ivanroigperez/prueba/trabajo/Guia_EcoIt.docx

DOCUMENTO INTERNO · NO SE ENTREGA

Guía para hacer el ACV con Eco-it

Trabajo de Ingeniería Simultánea: taburete-escalera plegable · Iván Roig Pérez

# 1. Qué hay que hacer

El profesor pide «un pequeño ACV del producto usando el software Eco-it». Yo no puedo ejecutar Eco-it, así que el capítulo 4 del trabajo ya tiene escrito todo lo demás (método, datos de entrada, comentarios y conclusiones) y deja en amarillo los huecos para los resultados. En la práctica del martes solo tienes que:

1. Crear en Eco-it las tres alternativas con los datos de las tablas de esta guía (si vas justo, como mínimo la alternativa 2).
2. En la alternativa 2, guardar una copia cambiando el aluminio primario por aluminio reciclado (es la variante de las conclusiones).
3. Hacer una captura de la pantalla de resultados de cada alternativa y anotar el valor de cada fase: producción, uso y eliminación.
4. Pegar las capturas y los valores en los huecos amarillos del capítulo 4 (o pasármelos y lo completo yo, junto con el gráfico comparativo).

Si el profesor dice que basta con el producto final, haz solo la alternativa 2 con su variante de aluminio reciclado y avísame: quito los apartados 4.2 y 4.4 y adapto la comparativa.

# 2. Antes de empezar

- Método de cálculo: si Eco-it deja elegir, usa la huella de carbono (kg CO₂-eq), que es lo que usa el índice de ejemplo del profesor. Si en clase usáis el Eco-indicador 99 (resultados en puntos o milipuntos), apunta los valores en esas unidades y dímelo para cambiar «kg CO₂-eq» en el texto.
- Nombres de los materiales: los de las tablas son genéricos. En Eco-it elige el material o proceso más parecido de su base de datos (por ejemplo, «aluminio primario» y «extrusión de aluminio»).
- Unidades: Eco-it trabaja en kg y en t·km. Todas las cantidades de esta guía ya están en esas unidades.
- El transporte de distribución (600 km en camión) se mete en la fase de producción, como dice el apartado 4.1. Si en clase lo ponéis en otra fase, cambia la frase del 4.1 y el nombre de la fila «Producción (incluye el transporte)».
- Si Eco-it permite dividir el producto en partes, crea una parte por cada fila de la tabla de producción: así podrás sacar el gráfico de impacto por componente, como en el índice de ejemplo.

# 3. Alternativa 2: aluminio y polipropileno (la elegida)

Fase / elemento | Material o proceso en Eco-it | Cantidad
PRODUCCIÓN
Largueros delanteros (2) | Aluminio primario + extrusión de aluminio | 0,963 kg
Patas traseras (2) | Aluminio primario + extrusión de aluminio | 0,893 kg
Travesaños (2) | Aluminio primario + extrusión de aluminio | 0,299 kg
Bielas y tirantes (4) | Aluminio primario + extrusión de aluminio | 0,136 kg
Plataforma | Polipropileno (PP) + moldeo por inyección | 0,363 kg
Peldaño | Polipropileno (PP) + moldeo por inyección | 0,297 kg
Pasadores (10) | Acero | 0,176 kg
Tacos (4) | Caucho | 0,042 kg
TRANSPORTE (dentro de producción)
Distribución, 600 km | Camión | 1,90 t·km
USO
Tacos de repuesto (4) | Caucho | 0,042 kg
ELIMINACIÓN
Metales reciclados (90 %) | Reciclaje de aluminio / reciclaje de acero | 2,063 kg / 0,158 kg
Metales a vertedero (10 %) | Vertedero | 0,247 kg
Plástico | Incineración de PP | 0,660 kg
Caucho (original y repuesto) | Incineración | 0,083 kg

Variante con aluminio reciclado: copia el producto y cambia «aluminio primario» por «aluminio reciclado» en las cuatro primeras filas (2,291 kg en total). Lo demás no cambia.

# 4. Alternativa 1: acero

Fase / elemento | Material o proceso en Eco-it | Cantidad
PRODUCCIÓN
Largueros delanteros (2) | Acero + conformado de tubo | 2,782 kg
Patas traseras (2) | Acero + conformado de tubo | 2,580 kg
Travesaños (2) | Acero + conformado de tubo | 0,865 kg
Plataforma y peldaño | Chapa de acero + estampación o doblado | 2,359 kg
Bielas y tirantes (4) | Acero | 0,394 kg
Pasadores (10) | Acero | 0,176 kg
Tacos (4) | Caucho | 0,042 kg
TRANSPORTE (dentro de producción)
Distribución, 600 km | Camión | 5,52 t·km
USO
Tacos de repuesto (4) | Caucho | 0,042 kg
ELIMINACIÓN
Acero reciclado (90 %) | Reciclaje de acero | 8,241 kg
Acero a vertedero (10 %) | Vertedero | 0,916 kg
Caucho (original y repuesto) | Incineración | 0,083 kg

# 5. Alternativa 3: madera

Fase / elemento | Material o proceso en Eco-it | Cantidad
PRODUCCIÓN
Largueros delanteros (2) | Madera dura (haya), aserrada | 0,712 kg
Patas traseras (2) | Madera dura (haya), aserrada | 0,661 kg
Travesaños (2) | Madera dura (haya), aserrada | 0,172 kg
Plataforma y peldaño | Contrachapado | 1,801 kg
Bielas y tirantes (4) | Acero | 0,394 kg
Pasadores (10) | Acero | 0,176 kg
Tacos (4) | Caucho | 0,042 kg
TRANSPORTE (dentro de producción)
Distribución, 600 km | Camión | 2,37 t·km
USO
Tacos de repuesto (4) | Caucho | 0,042 kg
ELIMINACIÓN
Madera | Incineración con recuperación de energía | 3,346 kg
Acero reciclado (90 %) | Reciclaje de acero | 0,513 kg
Acero a vertedero (10 %) | Vertedero | 0,057 kg
Caucho (original y repuesto) | Incineración | 0,083 kg

# 6. Dónde va cada resultado en el Word

Resultado de Eco-it | Dónde va en el capítulo 4
Valores por fase de la alternativa 1 | Tabla 13 y texto del apartado 4.2
Valores por fase de la alternativa 2 (primario y reciclado) | Tabla 14, texto del 4.3 y segunda conclusión del 4.5
Valores por fase de la alternativa 3 | Tabla 15 y texto del 4.4
Captura de resultados de cada alternativa | Ilustraciones 18, 21 y 22 (huecos amarillos)
Totales de las tres alternativas | Fila «Impacto del ciclo de vida» de la Tabla 16
Gráfico comparativo por fases | Ilustración 23 (si me pasas los valores, lo hago yo)

Al terminar, borra la nota amarilla del principio del capítulo 4 y comprueba que no queda ningún hueco amarillo (Ctrl+B y busca «[»).

# 7. Comprobación rápida de errores

Antes de Eco-it hice una estimación con otra base de datos (factores ICE de la Universidad de Bath). No sirve como resultado, porque el profesor pide Eco-it, pero sí para detectar errores al meter los datos:

Alternativa | Estimación previa (kg CO₂-eq)
1. Acero | ≈ 14
2. Aluminio + PP (aluminio primario) | ≈ 27
2. Con aluminio reciclado | ≈ 11
3. Madera | ≈ 3

- Diferencias de hasta un 50 % son normales: las bases de datos no son iguales.
- Si un resultado sale unas 1.000 veces mayor o menor, casi seguro que has metido gramos en lugar de kilos (o kg en lugar de t·km en el transporte).
- Lo que sí debería salir igual: la producción es la fase con más impacto en las tres alternativas y el uso es casi nulo. Si Eco-it dice otra cosa, revisa los datos o avísame, porque habría que cambiar los comentarios del capítulo.
