ivanroigperez/prueba/trabajo/Dudas_y_decisiones.docx

DOCUMENTO INTERNO · NO SE ENTREGA

Dudas y decisiones tomadas por intuición

Trabajo de Ingeniería Simultánea: taburete-escalera plegable · Iván Roig Pérez

Durante el trabajo he tenido que tomar muchas decisiones sin un enunciado ni un criterio del profesor que las respaldara. Aquí están todas las que no puedo justificar del todo: qué decidí, por qué, qué duda me queda y cómo comprobarla. Están ordenadas por lo que podrían afectar a la nota. Úsalo para preparar la defensa y, si puedes, para preguntar al profesor antes de entregar.

Impacto: Alto = podría cambiar una conclusión o costar bastante nota. Medio = discutible, pero defendible si lo explicas. Bajo = detalle.

Resumen

Nº | Duda | Impacto
1 | El ACV con Eco-it solo se ha hecho para la alternativa 2 (4) | Medio
2 | Decisión final: aluminio reciclado (antes era la madera) (4.1 y 4.4) | Medio
3 | Comprobaciones por cálculo manual (3.5) | Medio
4 | El pestillo está dimensionado pero no modelado (3.5 y 5.2) | Medio
5 | El capítulo 5 (QFD, AMFEC y análisis del valor) no lo pide el profesor (5) | Medio
6 | Hipótesis del ACV (4.2) | Medio
7 | Estudio de patentes no exhaustivo (2.5) | Medio
8 | Altura de 0,48 m a partir de un alcance de 1,24 veces la estatura (1.3) | Medio
9 | Costes y márgenes inventados (2.1) | Medio
10 | Qué entiende el profesor por «estructura» (1.7) | Bajo
11 | El AMFEC no calcula la criticidad (G × O) (5.2) | Bajo
12 | No he tenido acceso al texto de la UNE-EN 14183 (2.4 y normativa) | Bajo
13 | Elección de parámetros TRIZ (3.2) | Bajo
14 | QFD y AMFEC sin datos de clientes ni de ensayos (5) | Bajo
15 | Materiales de SolidWorks aproximados (3.4) | Bajo
16 | Datos de mercado (2.2) | Bajo
17 | Tres planos, generados por programa y no desde SolidWorks (6) | Bajo
18 | Embalaje y paletización (2.10) | Bajo

## 1. El ACV con Eco-it solo se ha hecho para la alternativa 2

IMPACTO MEDIO Apartado: 4

Qué decidí: Hacer el ACV en Eco-it solo de la alternativa elegida (aluminio y PP) y de su variante con aluminio reciclado. El capítulo 4 queda así: 4.1 selección frente al EDP (Tabla 12), 4.2 método y datos (Tabla 13), 4.3 resultados y 4.4 conclusiones.

Por qué: El profesor pide «un pequeño ACV del producto usando el software Eco-it», en singular, y lo repite en el mismo mensaje. El acero y la madera ya quedan descartados por el peso (P5) antes del ACV.

Qué duda me queda: Si el profesor esperaba comparar las tres alternativas, falta el ACV del acero y de la madera. Con los factores de Eco-it, el acero rondaría los 20 kg CO₂-eq (estimación mía, no calculada en Eco-it): con aluminio primario (35) la alternativa elegida sería la de más impacto, y con aluminio reciclado (10,5) pasa a ser mejor que el acero.

Cómo comprobarlo: Pregúntale al profesor si basta con el producto. Si pide las tres, se hacen en Eco-it partiendo del archivo de la alternativa 2 (unos 10-15 minutos cada una) y vuelvo a meter los apartados. Si en la defensa te preguntan por qué no el acero, la respuesta es el peso (P5) y el dato del aluminio reciclado.

## 2. Decisión final: aluminio reciclado (antes era la madera)

IMPACTO MEDIO Apartado: 4.1 y 4.4

Qué decidí: Aplicar primero un filtro de requisitos imprescindibles (Tabla 12). El acero y la madera no cumplen P5 y quedan descartados, así que se elige el aluminio reciclado.

Por qué: Otra revisión detectó que la versión anterior elegía la madera, que pesa 3,96 kg, y que la matriz le daba un 4 en peso. Con un 1 en peso ganaba el aluminio. Ahora la conclusión coincide con el modelo, los planos y el capítulo 5.

Qué duda me queda: La madera queda descartada por un peso calculado con una sección simplificada. Puede que un diseño de madera bien hecho también cumpla, pero no está demostrado.

Cómo comprobarlo: Si te preguntan por qué no la madera: incumple un requisito imprescindible y su modelo no está verificado. Queda como línea futura.

## 3. Comprobaciones por cálculo manual

IMPACTO MEDIO Apartado: 3.5

Qué decidí: Añadir el apartado 3.5 con cálculos sencillos: flexión y pandeo del larguero, plataforma, pasadores, vuelco y mecanismo.

Por qué: No había ninguna comprobación de P1, P2 ni R3.

Qué duda me queda: Los cálculos son simplificados (viga biapoyada, carga estática de 150 kg, coeficiente de seguridad de 2) y no sustituyen a un estudio por elementos finitos ni a los ensayos de la norma. La plataforma y el peldaño cumplen por poco (coeficiente de seguridad 2,0) y el peso final estimado (3,46 kg) apenas cumple P5. Los nervios no están dibujados en el modelo ni en los planos.

Cómo comprobarlo: Si quieres reforzarlo, haz un estudio estático de la plataforma en SolidWorks Simulation.

## 4. El pestillo está dimensionado pero no modelado

IMPACTO MEDIO Apartado: 3.5 y 5.2

Qué decidí: Calcular con el modelo cinemático cómo actúa el peso del usuario y dimensionar el pestillo en la articulación del peldaño.

Por qué: El cálculo demuestra que el peso sobre el peldaño tiende a cerrar el taburete, así que el pestillo es imprescindible.

Qué duda me queda: El pestillo sigue sin estar en el modelo 3D ni en los planos.

Cómo comprobarlo: Explícalo como diseño de detalle pendiente. Los números (522 N·m y unos 710 N por pasador) están en la Tabla 11.

## 5. El capítulo 5 (QFD, AMFEC y análisis del valor) no lo pide el profesor

IMPACTO MEDIO Apartado: 5

Qué decidí: Mantener las técnicas de rediseño como capítulo 5, entre la evaluación y la realización.

Por qué: Son materia del curso (apuntes de Técnicas de rediseño) y el capítulo está completo.

Qué duda me queda: El mensaje del profesor enumera las fases inicial, de información, técnico-creativa, de evaluación y de realización; el rediseño no aparece. Puede valorarlo, ignorarlo o preferir un trabajo más corto.

Cómo comprobarlo: Si quieres quitarlo, se elimina el capítulo 5 entero y hay que cambiar dos frases que lo citan (en el 2.1 y el 3.4). Dímelo y lo hago.

## 6. Hipótesis del ACV

IMPACTO MEDIO Apartado: 4.2

Qué decidí: 600 km de transporte en camión, reciclaje del 90 % de los metales, cambio de tacos una vez en 10 años, incineración del polipropileno y del caucho.

Por qué: Son valores razonables y habituales en ACV simplificados, y se pueden meter tal cual en Eco-it.

Qué duda me queda: Ninguno está medido. Además, el ACV no incluye el embalaje, el anodizado ni las mermas de fabricación (ya está dicho en el 4.2).

Cómo comprobarlo: Si en la práctica el profesor da otros escenarios (por ejemplo, otro porcentaje de reciclaje o un escenario de residuos urbanos de Eco-it), usa los suyos y cambia la frase del 4.2.

## 7. Estudio de patentes no exhaustivo

IMPACTO MEDIO Apartado: 2.5

Qué decidí: Analizar 4 documentos cercanos y citar 3 más.

Por qué: El índice pide 4 patentes.

Qué duda me queda: ES 1 070 877 U no puede estar en vigor: un modelo de utilidad dura como máximo 10 años y se solicitó en 2009. De US 12 419 421 B2 he confirmado titular, inventores, clasificación y fecha de concesión (23/09/2025), pero no la familia en otros países, porque Google Patents, Espacenet y la USPTO bloquean el acceso desde aquí. Tampoco he podido volver a comprobar que US 6 966 404 caducara por impago (en 2026 está expirada en cualquier caso).

Cómo comprobarlo: Busca US12419421B2 en worldwide.espacenet.com y mira «Also published as» o la pestaña de familia. Si sale una solicitud EP o WO, avísame: cambia la frase de que no afecta en España. Son 2 minutos.

## 8. Altura de 0,48 m a partir de un alcance de 1,24 veces la estatura

IMPACTO MEDIO Apartado: 1.3

Qué decidí: Usar la usuaria de percentil 5 (1,49 m) y un alcance de 1,24 × estatura para llegar a 2,30 m.

Por qué: Da un valor que coincide con los productos de referencia (Hailo K20: 46 cm).

Qué duda me queda: El factor 1,24 es una aproximación mía, no un dato de la tabla del INSHT. Los datos del INSHT son de 1999 y de población laboral (18 a 65 años), justo cuando digo que el producto está pensado también para personas mayores, que son más bajas. El objetivo de 2,30 m también lo fijé yo.

Cómo comprobarlo: Si en clase habéis usado otra tabla de alcance vertical, cambia el factor. Si el resultado sigue entre 0,45 y 0,50 m, el diseño no cambia.

## 9. Costes y márgenes inventados

IMPACTO MEDIO Apartado: 2.1

Qué decidí: Margen de la distribución del 38 %, margen del fabricante del 25 %, serie de 20.000 unidades al año y un reparto del coste industrial.

Por qué: Son hipótesis habituales y quedan marcadas como tales.

Qué duda me queda: No hay datos reales detrás. Los costes por componente del análisis del valor también son estimados, y su suma (13,46 €) supera lo previsto (12,50 €); lo he dejado escrito como hallazgo, no lo he escondido.

Cómo comprobarlo: Defiéndelo como estimación de orden de magnitud. Si en clase dieron márgenes típicos, usa esos.

## 10. Qué entiende el profesor por «estructura»

IMPACTO BAJO Apartado: 1.7

Qué decidí: Añadir el apartado 1.7 con el árbol de estructura del producto: conjunto, subconjuntos, piezas y la función de cada parte.

Por qué: El mensaje del profesor incluye «estructura» en la fase inicial, y el índice de ejemplo habla de «estructura de descomposición del producto», que es justo un árbol de conjuntos, subconjuntos y piezas.

Qué duda me queda: Los apuntes de la asignatura no están en abierto y no he podido comprobar la definición exacta (3/11/2026). Confianza: alrededor del 80 %.

Cómo comprobarlo: Si en los apuntes de Metodologías la «estructura» es la funcional y no la de piezas, avísame y lo adapto (el árbol de funciones del 1.4 ya cubre parte).

## 11. El AMFEC no calcula la criticidad (G × O)

IMPACTO BAJO Apartado: 5.2

Qué decidí: Usar solo el IPR = O × G × D.

Por qué: Es lo único que definen los apuntes de Técnicas de rediseño; la palabra «criticidades» solo aparece en el nombre de la técnica.

Qué duda me queda: Otra revisión lo señaló como fallo. Según tus apuntes no lo es, pero algunos profesores lo piden.

Cómo comprobarlo: Si quieres cubrirte, añade una columna G × O a la Tabla 15. Son 8 multiplicaciones.

## 12. No he tenido acceso al texto de la UNE-EN 14183

IMPACTO BAJO Apartado: 2.4 y normativa

Qué decidí: Describir la norma a partir de fuentes secundarias (AFESPO, Test and Research Centre, fichas de fabricantes).

Por qué: La norma es de pago.

Qué duda me queda: Comprobado el 3/11/2026: todo lo que dice el trabajo (150 kg, plataforma de hasta 1 m, peldaños a la misma distancia que del suelo al primero, barandilla si la plataforma es menor de 24 × 40 cm y está a más de 75 cm, solo ensayos de resistencia y deslizamiento lateral, sin marcado CE) coincide con las dos fuentes citadas. El texto oficial sigue sin consultar.

Cómo comprobarlo: Si la biblioteca de la universidad tiene acceso a AENOR, consulta la norma y corrige lo que haga falta.

## 13. Elección de parámetros TRIZ

IMPACTO BAJO Apartado: 3.2

Qué decidí: Contradicciones 14/1, 33/27 y 13/7.

Por qué: Son las que mejor describen el problema.

Qué duda me queda: Comprobadas el 3/11/2026 con la matriz clásica de Altshuller (hoja de cálculo de J. Hipple): 14/1 (1, 8, 40, 15) y 33/27 (17, 27, 8, 40) coinciden. La 13/7 decía 28, 10, 1 y 39 y es 28, 10, 19 y 39; ya está corregida. El parámetro 13 de TRIZ es la estabilidad de la composición del objeto, y aquí se usa como estabilidad frente al vuelco; un profesor estricto lo podría señalar.

Cómo comprobarlo: Si vuestra matriz de clase es otra versión, compara solo esas tres celdas.

## 14. QFD y AMFEC sin datos de clientes ni de ensayos

IMPACTO BAJO Apartado: 5

Qué decidí: Importancias, relaciones, percepción de la competencia y valores O, G y D puestos por mí.

Por qué: Es un trabajo académico sin encuestas ni prototipo.

Qué duda me queda: Los resultados (por ejemplo, que el peso sea lo más importante con un 15,7 %) salen de mis propias puntuaciones, así que en parte confirman lo que yo ya pensaba.

Cómo comprobarlo: Admítelo si te preguntan: en un proyecto real se harían encuestas a usuarios y ensayos de prototipos.

## 15. Materiales de SolidWorks aproximados

IMPACTO BAJO Apartado: 3.4

Qué decidí: PP copolímero en lugar de PP con 30 % de fibra de vidrio, haya en lugar de contrachapado en la plataforma y acero al carbono no aleado en lugar de S235.

Por qué: Son los que había en la biblioteca de SolidWorks en español.

Qué duda me queda: Las masas cambian poco (unos 170 g en el PP, ya indicado en el texto), pero el ACV usa el factor del contrachapado con la masa calculada con la densidad de la haya.

Cómo comprobarlo: Si quieres afinar, crea materiales personalizados en SolidWorks con la densidad correcta.

## 16. Datos de mercado

IMPACTO BAJO Apartado: 2.2

Qué decidí: Precios y características tomados de webs de tiendas en septiembre de 2026.

Por qué: No hay otra fuente.

Qué duda me queda: Comprobado en ikea.es el 3/11/2026: el BOLMEN cuesta 4,99 € (el trabajo decía 1,50 €; ya está corregido en la Tabla 4 y en la Ilustración 6) y el BEKVÄM sigue a 24,99 €. Varios pesos figuran como «n. d.».

Cómo comprobarlo: Nada pendiente.

## 17. Tres planos, generados por programa y no desde SolidWorks

IMPACTO BAJO Apartado: 6

Qué decidí: Dejar tres planos: conjunto abierto con lista de piezas, conjunto plegado y plano de fabricación del larguero delantero (con material, tolerancias, acabado y proceso).

Por qué: El profesor pide dos planos, uno de conjunto y otro de detalle o fabricación de una pieza. He quitado los de plataforma y peldaño y de piezas varias: no hacían falta y el de la plataforma no mostraba los nervios del apartado 3.5.

Qué duda me queda: Están dibujados proyectando el modelo con un programa, no con SolidWorks. Si el profesor pide los archivos de dibujo de SolidWorks, no los tienes.

Cómo comprobarlo: Si te los piden, usa la macro de planos (cad/Planos_macro_para_copiar.txt): crea más hojas de las necesarias; quédate con la de conjunto y añade las cotas a mano.

## 18. Embalaje y paletización

IMPACTO BAJO Apartado: 2.10

Qué decidí: Caja de 880 × 470 × 60 mm y 39 unidades por palé, de canto.

Por qué: Sale del tamaño plegado medido en el modelo (861 × 450 × 40 mm).

Qué duda me queda: En la versión anterior la caja medía 640 mm, un error que he corregido en esta revisión. No he contado cantoneras ni el grosor real del cartón.

Cómo comprobarlo: Nada que hacer; solo tenlo en cuenta si comparas con una versión antigua del documento.

# Consejo final para la defensa

Ya no queda ninguna duda de impacto alto. Las de impacto medio son las que un profesor de Ingeniería Mecánica puede ver con más facilidad. No hace falta resolverlas todas; basta con que las conozcas y sepas explicar por qué se tomó esa decisión y cuál sería el siguiente paso. Decir «esto no está verificado y se comprobaría así» suele puntuar mejor que dar un dato que luego no sabes justificar.

Recuerda también que todo el trabajo tiene que poder defenderlo quien lo firma. Repasa los cálculos del ACV, la cinemática del plegado y la matriz de decisión hasta que puedas explicarlos sin el documento delante.
