ivanroigperez/prueba/entrega/Trabajo_Taburete_Ivan_Roig_Perez_reducido.pdf

### UNIVERSIDAD DE LA RIOJA

Grado en Ingeniería Mecánica, Ingeniería Simultánea

T R A B A J O D E A S I G N A T U R A , C U R S O 2 0 2 6 - 2 0 2 7

# Taburete-escalera plegable

# de uso doméstico

Diseño y ciclo de vida con la metodología de Ingeniería Simultánea

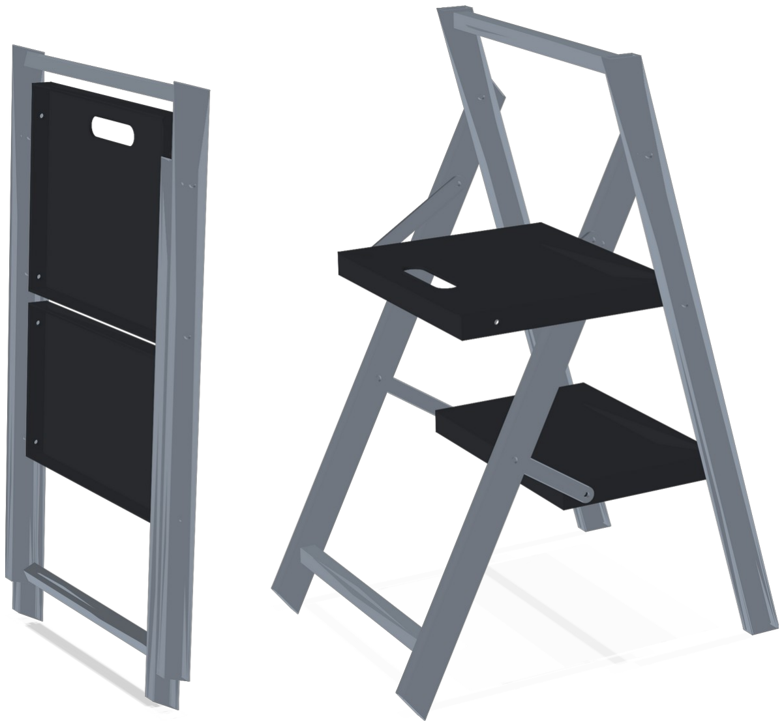
[picture p28: figure]

Plegado y abierto

0,48 m

altura de plataforma

150 kg

carga máxima

## 40 mm

espesor plegado

3,46 kg

peso estimado

A l u m n o

## Iván Roig Pérez

Logroño, 2026

### ÍNDICE

Taburete-escalera plegable, Iván Roig Pérez. Página 2

### ÍNDICE DE ILUSTRACIONES

Ilustración 1. Determinación de la altura de la plataforma superior | 6
Ilustración 2. Árbol de estructura del taburete-escalera: subconjuntos, piezas y funciones | 8
Ilustración 3. Figura 1 del modelo de utilidad ES 1 070 877 U, con el detalle D del vástago de bloqueo | 11
Ilustración 4. Mapa mental del taburete-escalera | 14
Ilustración 5. Boceto inicial del concepto | 16
Ilustración 6. Esquema cinemático definitivo: posiciones abierta, intermedia y plegada | 17
Ilustración 7. Ensamblaje abierto, vista lateral (SolidWorks) | 18
Ilustración 8. Ensamblaje plegado, vista isométrica (SolidWorks) | 18
Ilustración 9. Fase de producción de la alternativa 2 en Eco-it | 21
Ilustración 10. Resultados de Eco-it de la alternativa 2: aluminio y polipropileno | 21
Ilustración 11. Resultados de Eco-it de la alternativa 2 con aluminio reciclado | 22
Plano 1. Conjunto abierto con lista de piezas | 23
Plano 2. Conjunto plegado | 24
Plano 3. Larguero delantero: plano de fabricación | 24

### ÍNDICE DE TABLAS

Tabla 1. Requisitos del producto | 7
Tabla 2. Propiedades del producto y requisito del que derivan | 8
Tabla 3. Cálculo del coste objetivo a partir del precio de venta | 9
Tabla 4. Taburetes-escalera del mercado español (n. d.: dato no disponible) | 9
Tabla 5. Documento EDP del taburete-escalera | 11
Tabla 6. Legislación y normativa aplicable | 13
Tabla 7. Comprobaciones de resistencia y estabilidad de la alternativa 2 (C. S.: coeficiente de seguridad).........19
Tabla 8. Comprobación de las alternativas frente a las propiedades imprescindibles del EDP | 20
Tabla 9. Resultados de Eco-it de la alternativa 2: aluminio y polipropileno (kg CO₂-eq) | 21

Taburete-escalera plegable, Iván Roig Pérez. Página 3

### 1. ETAPA INICIAL

### 1.1. INTRODUCCIÓN

### 1.1.1. CONTEXTO

Buena parte del espacio de almacenaje de una vivienda está en altura, en muebles altos de cocina, armarios que llegan al techo, altillos o estanterías. En una cocina estándar los muebles altos se colocan más o menos entre 1,45 y 2,20 m del suelo, y los altillos pueden llegar a 2,50 m.

Estas alturas no están al alcance de todo el mundo. El percentil 5 de las mujeres españolas mide 1,49 m (INSHT). El alcance vertical máximo de pie es de unas 1,24 veces la estatura, así que esta usuaria llega a unos 1,85 m. La balda superior de un mueble alto y todo el altillo le quedan fuera de alcance. Un hombre de estatura media, de 1,70 m y con un alcance de unos 2,11 m, tampoco llega al altillo sin ayuda.

Las viviendas, en especial en las ciudades, son cada vez más pequeñas, y cualquier objeto auxiliar tiene que poder guardarse en poco sitio. Por eso mucha gente acaba subiéndose a una silla, a una caja o incluso a la encimera para alcanzar lo que necesita, con el riesgo de caída que eso supone.

Las caídas son el accidente doméstico y de ocio más frecuente, con el 51,1 % del total, según el informe DADO (Detección de Accidentes Domésticos y de Ocio) del Ministerio de Sanidad. La mayoría de estos accidentes ocurre dentro de la vivienda, el 54,5 %. La población española está cada vez más envejecida. A 1 de enero de 2025 el 20,7 % tenía 65 años o más (INE), y en este grupo una caída desde poca altura puede tener consecuencias graves.

### 1.1.2. MOTIVACIÓN

El taburete-escalera es un producto muy común. En el mercado casi siempre hay que elegir entre un modelo robusto y uno fácil de guardar. Los más robustos y estables pesan y ocupan bastante, y acaban guardados en el trastero. El usuario vuelve entonces a subirse a la silla. Los más compactos y baratos dan poca sensación de seguridad, con peldaños estrechos, bloqueos poco fiables o apoyos que resbalan.

La motivación del trabajo es diseñar un taburete-escalera doméstico seguro y estable durante el uso que, al mismo tiempo, se guarde y se mueva con facilidad. El diseño aplica criterios de ecodiseño para reducir su impacto ambiental en todo el ciclo de vida.

### 1.1.3. NECESIDADES

Las necesidades del usuario que se han identificado son las siguientes:

- Poder alcanzar con seguridad objetos situados hasta 2,20-2,50 m de altura.
- Estabilidad al subir, al estar arriba y al bajar, sin balanceos ni riesgo de vuelco, incluso inclinando el cuerpo hacia un lado.
- Apoyar bien el pie, con peldaños de tamaño suficiente y superficie antideslizante.
- Poder guardarlo en poco espacio cuando no se utiliza.
- Poder llevarlo de una habitación a otra con una sola mano.
- Abrirlo y plegarlo de forma rápida e intuitiva, sin riesgo de pillarse los dedos.
- Que sea apto para personas mayores, con algún punto de agarre en el que apoyarse.
- Que no dañe el suelo ni haga ruido al usarlo o moverlo.

Taburete-escalera plegable, Iván Roig Pérez. Página 4

- Que sea duradero y que al final de su vida útil se pueda reparar o reciclar.
- Que tenga un precio asequible para un producto de uso doméstico.

### 1.2. DEFINICIÓN

El producto es un taburete-escalera plegable de uso doméstico. Es un elemento auxiliar de pocos peldaños que permite a una persona subir con seguridad para llegar a las zonas altas de la vivienda (muebles altos de cocina, altillos, estanterías, lámparas o cortinas). Cuando no se usa, se pliega para guardarlo en poco espacio.

Está pensado para usos breves y frecuentes dentro de casa, por cualquier miembro de la familia. El uso profesional queda para las escaleras de mano y de tijera.

### 1.3. OBJETIVOS

Objetivo general:

Diseñar un taburete-escalera doméstico seguro y estable, ligero y fácil de guardar, con un precio competitivo y un impacto ambiental reducido en todo su ciclo de vida.

Objetivos específicos:

1. Que una usuaria de percentil 5 alcance con comodidad 2,30 m de altura, lo que cubre todo el mueble alto y la balda media del altillo.
2. Soportar a un usuario adulto de hasta 150 kg sin riesgo de rotura, deformación ni vuelco.
3. Que ocupe el menor espesor posible una vez plegado, para guardarlo en huecos estrechos.
4. Que se pueda abrir, cerrar y transportar con una sola mano.
5. Cumplir la norma UNE-EN 14183 sobre taburetes-escalera.
6. Reducir la huella de carbono frente a los modelos equivalentes del mercado, con materiales reciclables y fáciles de separar.
7. Mantener un precio de venta similar o inferior al de la competencia de gama media.

La altura de la plataforma sale de un cálculo sencillo. Para llegar a 2,30 m con un alcance de unos 1,85 m, la plataforma superior tiene que estar al menos a 0,45 m del suelo. Se ha tomado 0,48 m en dos peldaños iguales de 0,24 m, como exige la norma UNE-EN 14183, que pide la misma distancia entre peldaños que del suelo al primer peldaño (Ilustración 1). Es una altura muy parecida a la de los modelos de referencia, como el Hailo K20, con la plataforma a 46 cm.

Taburete-escalera plegable, Iván Roig Pérez. Página 5

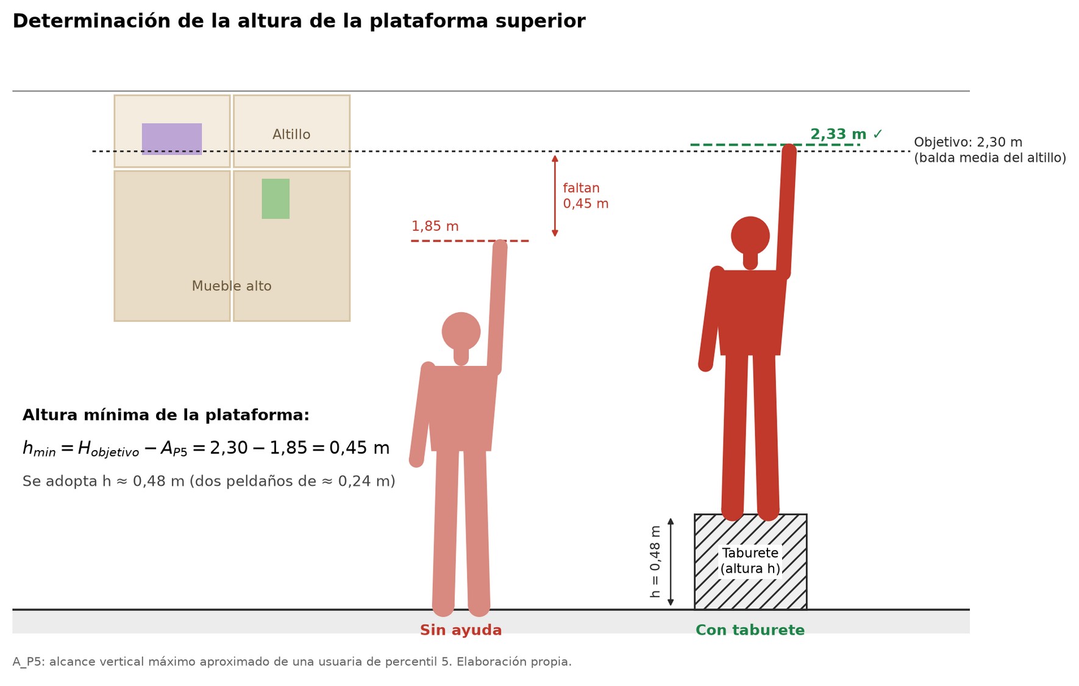
[picture p29: figure]

Ilustración 1. Determinación de la altura de la plataforma superior. Elaboración propia.

### 1.4. FUNCIONES

Las funciones del producto se han clasificado como en la asignatura, en funciones de uso, de manipulación y comunicativas. La función principal es elevar al usuario con seguridad para que alcance las zonas altas.

Funciones de uso (principales):

- Soportar el peso del usuario al subir, al estar de pie y al bajar.
- Mantener la estabilidad aunque el usuario se incline o cambie el peso de un pie a otro.
- Proporcionar un apoyo firme y cómodo para el pie.
- Ofrecer un punto de agarre en el que apoyarse al subir y bajar.

Funciones de manipulación (secundarias):

- Desplegarse y plegarse de forma rápida.
- Quedar bloqueado en posición de uso para que no se cierre solo.
- Poder transportarse de una habitación a otra con una mano.
- Almacenarse en poco espacio cuando no se usa.

Funciones comunicativas (secundarias):

- Transmitir sensación de seguridad y solidez al usuario.
- Indicar la carga máxima admisible y las advertencias de uso.
- Dejar claro, a simple vista, cómo se abre y cuándo está bien bloqueado.
- Integrarse en la cocina o en el salón, donde muchas veces estará a la vista.

Taburete-escalera plegable, Iván Roig Pérez. Página 6

### 1.5. REQUISITOS

Los requisitos son las condiciones que debe cumplir el producto para realizar bien sus funciones (Tabla 1). Se han agrupado en los tipos vistos en clase (ergonómicos, estéticos, de uso y medioambientales), más los de seguridad y los económicos, y se han separado en imprescindibles (I) y deseables (D).

Código | Tipo | Requisito | I / D
R1 | Seguridad | Soportar a un adulto de hasta 150 kg | I
R2 | Seguridad | No volcar al subir, bajar o inclinarse hacia un lado | I
R3 | Seguridad | No poder plegarse accidentalmente mientras se usa | I
R4 | Seguridad | Peldaños y apoyos antideslizantes | I
R5 | Seguridad | Cumplir la norma UNE-EN 14183 | I
R6 | Ergonómico | Permitir alcanzar 2,30 m a una usuaria de percentil 5 | I
R7 | Ergonómico | Peldaños en los que quepa el pie completo | I
R8 | Ergonómico | Altura entre peldaños cómoda de subir, también para personas mayores | I
R9 | Ergonómico | Abrirse y cerrarse con una mano y sin riesgo de pillarse los dedos | I
R10 | Ergonómico | Ser ligero para poder llevarlo con una mano | I
R11 | Ergonómico | Disponer de un punto de agarre al subir | D
R12 | De uso | Ocupar poco espacio una vez plegado | I
R13 | De uso | No marcar el suelo ni hacer ruido | I
R14 | De uso | No necesitar mantenimiento | D
R15 | De uso | Piezas de desgaste (tacos, recubrimientos) sustituibles | D
R16 | Estético | Transmitir robustez y seguridad | I
R17 | Estético | Aspecto sencillo que no desentone en la vivienda | D
R18 | Estético | Disponible en varios acabados de color | D
R19 | Medioambiental | Fabricado con materiales reciclables | I
R20 | Medioambiental | Larga vida útil | I
R21 | Medioambiental | Fácil de desmontar para separar los materiales al final de su vida | D
R22 | Medioambiental | Embalaje mínimo y reciclable | D
R23 | Económico | Precio de venta competitivo | I
Tabla 1. Requisitos del producto. Elaboración propia.

### 1.6. PROPIEDADES, ASPECTO Y FORMA

### 1.6.1. PROPIEDADES

Las propiedades traducen los requisitos a valores concretos y medibles, que sirven para comprobar si el diseño es correcto (Tabla 2). Se dividen en pasivas, ligadas a la estructura y a los materiales, y activas, ligadas al movimiento y al funcionamiento.

Código | Requisito | Propiedad (valor objetivo) | Tipo
P1 | R1 | Carga máxima de uso: 150 kg, sin deformación permanente en el ensayo de resistencia de la norma | Pasiva
P2 | R2, R5 | Superar los ensayos de resistencia y de deslizamiento lateral de la UNE-EN 14183; base de apoyo más ancha que la plataforma | Pasiva
P3 | R6, R8 | Altura de la plataforma superior: 0,48 m, con dos peldaños separados unos 0,24 m | Pasiva
P4 | R7 | Profundidad de peldaño ≥ 200 mm y anchura ≥ 350 mm | Pasiva
P5 | R10 | Peso total ≤ 3,5 kg | Pasiva
P6 | R12 | Espesor plegado ≤ 50 mm | Pasiva
P7 | R3, R9 | Apertura y cierre en ≤ 3 s con una mano, con bloqueo automático en posición de uso | Activa
P8 | R9 | Holguras en zonas móviles < 8 mm o > 25 mm, para evitar atrapamientos | Activa
P9 | R4, R13 | Tacos de apoyo de elastómero no marcante y superficie de peldaño antideslizante | Pasiva
P10 | R19, R21 | ≥ 90 % del peso en materiales reciclables; piezas de un solo material, unidas de forma desmontable | Pasiva
P11 | R20 | Vida útil ≥ 10 años en uso doméstico | Pasiva

Taburete-escalera plegable, Iván Roig Pérez. Página 7

P12 | R23 | Precio de venta objetivo ≤ 45 € IVA incluido (ver apartado 2.1) | -
Tabla 2. Propiedades del producto y requisito del que derivan. Elaboración propia.

### 1.6.2. ASPECTO

Se busca un aspecto sencillo y actual, con líneas limpias y colores neutros (blanco, gris antracita o acabado madera). Así el taburete no desentona si se queda a la vista en la cocina o en el salón. Tiene que transmitir robustez, y el usuario debe ver antes de subirse que es firme y que está bien bloqueado. Las indicaciones de uso y la carga máxima se deben leer con claridad sin recargar el diseño.

### 1.6.3. FORMA

La forma se subordina a la función. Abierto, el taburete necesita una base de apoyo más amplia que la parte superior, para que el centro de gravedad del usuario quede siempre dentro de ella y no vuelque. Plegado, debe quedar casi plano para guardarlo en huecos estrechos. No puede tener aristas vivas ni salientes, y necesita una zona para cogerlo con una mano al transportarlo.
1.7. ESTRUCTURA
La estructura describe cómo se organiza el producto en conjuntos, subconjuntos y piezas, y qué función cumple cada parte. En la etapa inicial se planteó a partir de las funciones del apartado 1.4. Después se completó con las piezas del diseño del apartado 3.4, en el que el bastidor se dividió en delantero y trasero (Ilustración 2).


Ilustración 2. Árbol de estructura del taburete-escalera: subconjuntos, piezas y funciones. Elaboración propia.
Los dos bastidores y las dos superficies de apoyo son piezas sencillas de un solo material, y todas las uniones son articulaciones con pasadores desmontables. Con esta estructura es fácil reparar el taburete, cambiar las piezas de desgaste y separar los materiales al final de su vida útil (requisitos R15 y R21).

Taburete-escalera plegable, Iván Roig Pérez. Página 8

### 2. ETAPA DE INFORMACIÓN

La etapa de información reúne lo necesario para definir el producto antes de diseñarlo, es decir, costes, competencia, patentes y normativa. Con esa información se redacta el EDP (Especificaciones de Diseño del Producto). En la metodología de la asignatura esta etapa queda abierta durante todo el proceso, y algunos valores de la etapa inicial se han corregido con lo que se ha encontrado en ella.

### 2.1. COSTES

El coste objetivo parte del precio de venta de la competencia (apartado 2.2). Los taburetes plegables de dos peldaños y 150 kg de carga se venden en España entre unos 19 € (modelos básicos de aluminio) y 86 € (modelos de marca con peldaños anchos). El precio medio es de unos 54 €. Se quiere situar el producto por debajo de las marcas de gama media-alta y por encima de los modelos más baratos en prestaciones.

Partiendo de un precio de venta al público (PVP) objetivo de 45 € con IVA, se ha estimado el coste de fabricación máximo del producto (Tabla 3).

Concepto | Cálculo | Importe
PVP objetivo (IVA incluido) | - | 45,00 €
PVP sin IVA | 45 / 1,21 | 37,19 €
Margen de la distribución (tienda) | 38 % del PVP sin IVA (hipótesis) | − 14,13 €
Precio de venta del fabricante | 37,19 − 14,13 | 23,06 €
Margen del fabricante | 25 % (hipótesis) | − 5,77 €
COSTE INDUSTRIAL OBJETIVO | | 17,30 €
Tabla 3. Cálculo del coste objetivo a partir del precio de venta. Elaboración propia.
El coste industrial se ha repartido en unos 8,50 € de materiales, 4,00 € de transformación (corte, doblado, inyección y acabado) y 1,50 € de montaje. El embalaje supone 1,00 € y los gastos generales y la amortización de utillajes, 2,30 €. Los márgenes son hipótesis habituales del sector.

Estos costes solo se alcanzan con series largas, del orden de 20.000 unidades al año, que permiten amortizar herramientas caras como los moldes de inyección o las matrices de estampación.

### 2.2. ESTUDIO DE MERCADO, PRODUCTOS SIMILARES Y SOLUCIONES

Se han analizado los taburetes-escalera que se venden en las principales tiendas españolas (IKEA, Leroy Merlin, Obramat y ferreterías online). Sus características y precios están en la Tabla 4.

Producto | Material | Peldaños / altura plataforma | Carga | Peso | Plegado | Precio
IKEA BEKVÄM | Haya maciza | 2 / 50 cm (alto total) | 100 kg | n. d. | No | 24,99 €
IKEA BOLMEN | PP (≥ 50 % reciclado) | 1 / unos 25 cm | 100 kg | n. d. | No | 4,99 €
Altipesa aluminio 2 peld. | Aluminio + plataforma de acero | 2 / n. d. | 150 kg | 2 kg | Sí | 19,27 €
Hailo K20 (4396-901) | Acero | 2 / 46 cm | 150 kg | 5,2 kg | Sí, 5 cm | 58,87 €
Hailo Safety (4312-001) | Acero, asidero 50 cm | 2 / n. d. | 150 kg | n. d. | Sí | 52,39 €
Hailo L90 (4442-701) | Aluminio | 2 / unos 49 cm (alto total) | 150 kg | n. d. | Sí, 19 cm | 86,03 €
Leroy Merlin, taburete doméstico | Acero pintado blanco | 2 / 43 cm | 150 kg | n. d. | Sí, 8 cm | n. d.

Tabla 4. Taburetes-escalera del mercado español (n. d.: dato no disponible). Fuente: webs de fabricantes y distribuidores, septiembre y noviembre de 2026.

Taburete-escalera plegable, Iván Roig Pérez. Página 9

Conclusiones del estudio de mercado:

Hay un hueco entre los modelos baratos y poco cómodos y los robustos, pesados y caros. El nuevo diseño debe ofrecer los peldaños profundos y la carga de 150 kg de los modelos de marca, con un peso y un precio más cercanos a los de los básicos. Al compararlas con la competencia, dos propiedades de la etapa inicial resultaron poco exigentes, el espesor plegado de 80 mm y el peso de 5 kg. Como recomienda el tema de EDP cuando se detectan deficiencias frente a lo existente, se han cambiado a 50 mm y 3,5 kg.

### 2.3. EDP (DOCUMENTO DE ESPECIFICACIONES DE DISEÑO DEL PRODUCTO)

El EDP recoge las especificaciones y limitaciones que el mercado y la empresa imponen al producto antes de la fase creativa (Tabla 5). Sigue los apartados vistos en la asignatura, con frases cortas y sin orientar el diseño hacia una solución concreta.

Especificación | Requisitos y limitaciones
Almacenaje | Almacenable en interior durante al menos 2 años sin deterioro. Temperatura de 0 a 40 °C, humedad relativa ≤ 80 %. Cajas apilables sin dañar el producto.
Calidad y fiabilidad | Ningún fallo estructural con 150 kg durante toda su vida útil. Bloqueo fiable en todas las aperturas. Registro de fallos y devoluciones para retroalimentar el diseño.
Cantidad | Serie larga: unas 20.000 unidades/año. Justifica utillajes de inyección y estampación.
Competencia | Mejorar a los modelos básicos en profundidad de peldaño y seguridad percibida, y a los modelos de marca en peso y precio.
Consumidor / cliente | Hogares españoles y europeos. Usuario de cualquier edad adulta, con especial atención a personas mayores. Comprador en gran superficie de bricolaje, tienda de hogar u online.
Coste | PVP ≤ 45 € IVA incluido. Coste industrial ≤ 17,30 €.
Documentación | Manual con uso correcto e incorrecto, carga máxima, mantenimiento, reparación y reciclaje. Pictogramas de advertencia en el propio producto. Referencia a la UNE-EN 14183.
Embalaje | Caja de cartón reciclado, sin plásticos ni poliestireno. Debe proteger las esquinas y servir como expositor en tienda.
Entorno | Uso en interior (cocina, baño, salón, trastero). Resistente a la humedad del baño y a productos de limpieza domésticos.
Ergonomía | Alcance de 2,30 m para usuaria P5. Peldaños donde quepa el pie entero. Subida cómoda para personas mayores. Manejo y transporte con una mano.
Estética | Aspecto limpio y actual, colores neutros. Debe transmitir solidez.
Facilidad de fabricación | Pocas piezas, preferiblemente comunes a varias posiciones. Procesos estándar subcontratables.
Funcionalidad | Abrir y cerrar en ≤ 3 s. Bloqueo automático en posición de uso. Imposible de cerrar con el usuario encima.
Implicaciones sociopolíticas | Ninguna relevante. Favorece la autonomía de personas mayores en su hogar.
Instalación | No requiere instalación: se entrega montado y listo para usar.
Legislación | Reglamento (UE) 2023/988 de seguridad general de los productos. Responsabilidad por productos defectuosos (RDL 1/2007). REACH.
Mantenimiento | Sin mantenimiento periódico. Tacos y recubrimientos sustituibles como repuesto.
Normas | UNE-EN 14183 (taburetes-escalera) como norma de referencia.
Materiales | Reciclables, sin sustancias restringidas por REACH. Preferiblemente con contenido reciclado.
Patentes | No invadir patentes en vigor en los países de venta (ver apartado 2.5).
Peso | ≤ 3,5 kg.
Planificación | Diseño y prototipo en 6 meses; ensayos y preserie en 3 meses más.
Procesos | Definir los procesos de cada componente y los tratamientos superficiales (pintura, anodizado…) en la etapa de diseño de detalle.
Reciclaje | ≥ 90 % del peso reciclable. Piezas de un solo material, separables con herramientas comunes.
Residuos | Minimizar recortes y mermas de fabricación. Sin piezas que acaben en vertedero por imposibles de separar.
Seguridad | Carga máxima 150 kg. Sin aristas vivas. Holguras que eviten atrapar los dedos. Antideslizante en peldaños y apoyos.
Restricciones de empresa | Aprovechar procesos subcontratados (tubo, inyección, estampación). Montaje final en la propia empresa.
Restricciones de mercado | Producto para el mercado europeo: marcas y textos en varios idiomas.
Tamaño y volumen | Abierto: huella de unos 500 × 450 mm. Plegado: espesor ≤ 50 mm.
Transporte | Por carretera en palé europeo. Caja con asa o hendidura para cogerla.

Taburete-escalera plegable, Iván Roig Pérez. Página 10

Vida del producto (mercado) | Permanencia estimada en el mercado de 8 a 10 años con pequeñas actualizaciones de color y acabado.
Vida útil | ≥ 10 años en uso doméstico.
Tabla 5. Documento EDP del taburete-escalera. Elaboración propia.

### 2.4. ESTUDIO DE PATENTES

Antes de diseñar un producto para venderlo hay que conocer las patentes sobre productos similares, porque podrían impedir su comercialización. Una patente da a su titular el derecho exclusivo a explotar una invención durante 20 años en el territorio donde se concede, a cambio de hacerla pública. En España existe también el modelo de utilidad, que protege durante 10 años invenciones de menor rango, como una configuración o estructura que da una ventaja práctica. La protección es territorial y una patente de Estados Unidos no tiene efectos en España.

La búsqueda se ha hecho en Google Patents, Espacenet (Oficina Europea de Patentes) e INVENES (Oficina Española de Patentes y Marcas), con palabras clave como “taburete plegable”, “escalera plegable”, “folding step stool” y “Klapptritt”. Se han analizado las cuatro más cercanas al producto.

2.4.1. PATENTE PRIMERA: ES 1 070 877 U, DISPOSITIVO DE ENCLAVAMIENTO PARA TABURETES PLEGABLES Y SIMILARES
Modelo de utilidad español (A47C 7/00) de Gesco, S.L., con Jorge Pajares Calvo como inventor. Se presentó el 26/06/2009 con el número U 200901059 y está caducado, ya que un modelo de utilidad protege como máximo 10 años (hasta 2019 en este caso).

Dispositivo que mantiene desplegado un taburete plegable. En una de las patas, junto a la articulación con la plataforma superior, hay un vástago que atraviesa la pata y que un muelle mantiene sobresaliendo. La pared lateral de la plataforma tiene un orificio enfrentado al vástago y, antes de él, una zona abombada hacia fuera. Al desplegar el taburete, esa zona empuja el vástago hacia dentro. Cuando el vástago llega al orificio, el muelle lo vuelve a sacar, el vástago queda encajado y el taburete se bloquea abierto.

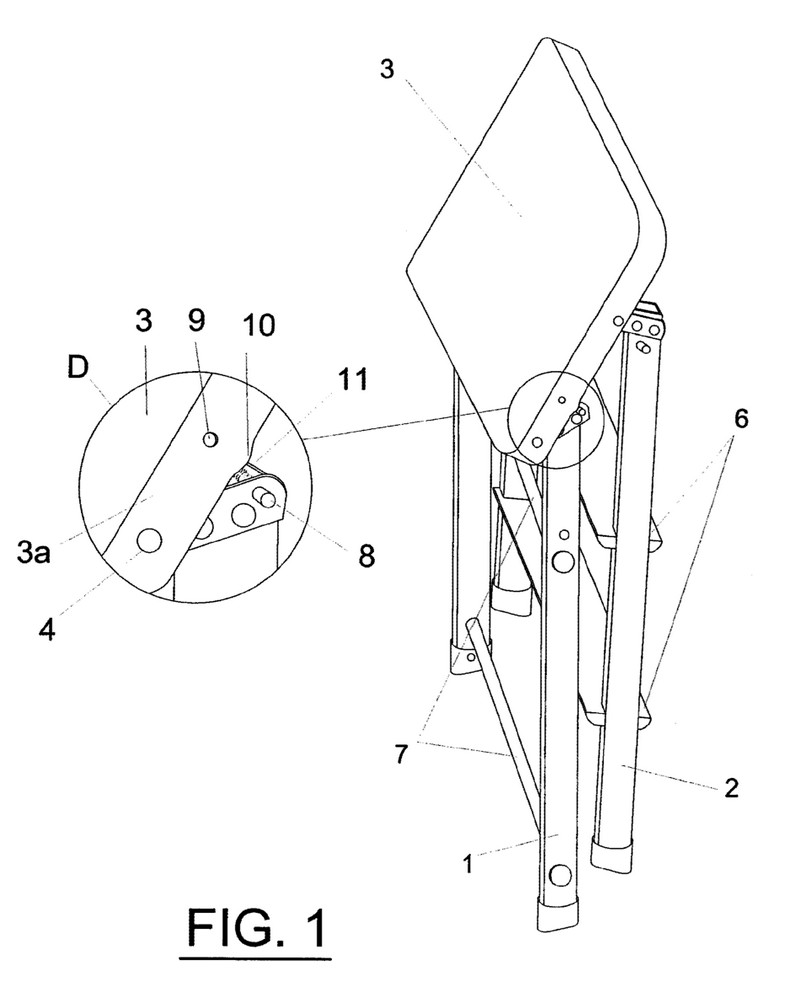
[picture p30: figure]

Ilustración 3. Figura 1 del modelo de utilidad ES 1 070 877 U, con el detalle D del vástago de bloqueo. Fuente: OEPM y Google Patents.

Taburete-escalera plegable, Iván Roig Pérez. Página 11

No afecta al producto. Es el documento más parecido al producto, un taburete de dos peldaños con bloqueo automático al abrirlo. El modelo de utilidad ha caducado y su solución se puede usar libremente. Es una buena referencia para el bloqueo automático que se busca (principio TRIZ 10, acción previa).

2.4.2. PATENTE SEGUNDA: US 6 454 050 B2, FOLDABLE STEP STOOL WITH LEG LOCK AND HANDLE Patente de Estados Unidos de Cosco Management, Inc. (hoy Dorel Home Furnishings), con William B. Gibson y otros como inventores. Se solicitó el 17/04/2001, con prioridad de 11/08/2000, se concedió el 24/09/2002 y ha expirado.

Taburete-escalera plegable con un bastidor formado por una pata delantera y una pata trasera que se mueven una respecto a la otra, y un asa de transporte que gira sobre una de las patas. Una pieza de retención unida al asa gira con ella y bloquea la pata delantera con la trasera cuando el taburete está plegado, para que no se abra al transportarlo.

No afecta al producto. Es una patente estadounidense, sin efectos en España, y ha expirado. Aporta la idea de usar el asa de transporte para mantener el taburete cerrado al llevarlo, útil en este producto para que no se abra al colgarlo en la pared.

2.4.3. PATENTE TERCERA: US 6 966 404 B2, FOLDING STEP STOOL
Patente de Estados Unidos de Cosco Management, Inc. (hoy Dorel Home Furnishings), con Paul K. Meeker como inventor. Se solicitó el 19/05/2003, se concedió el 22/11/2005 y ha expirado por impago de tasas.

Taburete de un escalón con dos patas que giran respecto al escalón. Cada pata tiene un soporte de bloqueo que la mantiene fija en posición de uso y, al accionarlo, permite plegar las patas paralelas al escalón para guardarlo. El escalón tiene unas aberturas que sirven de asa y una ventana por la que se ve el soporte de bloqueo cuando está bien cerrado.

No afecta al producto. Tampoco tiene efectos en España y ha expirado. Aporta dos ideas útiles, el asa formada por aberturas en la plataforma y el indicador visual de bloqueo. Este indicador responde a la función comunicativa “dejar claro cómo se abre y cuándo está bien bloqueado” del apartado 1.4.

2.4.4. PATENTE CUARTA: US 12 419 421 B2, FOLDABLE LOCKING STEP STOOL
Patente de Estados Unidos (A47C 4/10) de Jool Products, LLC (Lakewood, Nueva Jersey), con Judah Bergman, Yishak Sultan y Jiaxuan Ma como inventores. Se solicitó el 12/05/2022 (17/743,098), se publicó como US 2023/0363538 A1 el 16/11/2023 y se concedió el 23/09/2025. Está en vigor en Estados Unidos.

Taburete plegable cuya plataforma se divide en dos mitades unidas por una bisagra. Tiene un mecanismo de bloqueo a prueba de niños con dos deslizadores, uno en cada lado de la plataforma. Hay que accionarlos a la vez para liberar dos pestillos con muelle y poder plegarlo. Con este sistema un niño no puede cerrarlo y pillarse los dedos. Incluye agarres antideslizantes sobremoldeados y un asa integrada que queda oculta cuando el taburete está en uso.

No afecta al producto. La patente solo protege el invento en Estados Unidos. En su portada no figura ninguna solicitud internacional (PCT) ni prioridad extranjera, y en la búsqueda no ha aparecido ninguna solicitud europea de la misma familia. El diseño propuesto no divide la plataforma en dos

Taburete-escalera plegable, Iván Roig Pérez. Página 12 mitades ni usa dos deslizadores simultáneos, que son elementos esenciales de la reivindicación. Para vender el producto en Estados Unidos habría que evitar ese mecanismo.

Se han consultado otras tres patentes. Dos son de Hailo Werk, la EP 2 660 419 A2 (“Steiggerät, nämlich Klapptritt oder Trittleiter”) y la EP 3 056 656 A1 (soporte para pies de escaleras y taburetes). La tercera es la US 6 390 238 B1 de Cosco, una versión anterior de la patente segunda.

El concepto general de taburete-escalera plegable de dos peldaños no es patentable, al no cumplir el requisito de novedad. Existe desde hace décadas y hay muchas patentes sobre él, como las analizadas. Sí podría protegerse una solución concreta del diseño, como un mecanismo de bloqueo que combine de forma nueva el asa de transporte con el cierre de seguridad. Al ser una mejora de la configuración del producto con una ventaja práctica, la vía más adecuada sería un modelo de utilidad en España, más rápido y barato que una patente. La apariencia externa se podría proteger como diseño industrial y el nombre comercial como marca.

### 2.5. LEGISLACIÓN A CUMPLIR

Los taburetes-escalera no tienen una directiva europea propia y no llevan marcado CE. Deben cumplir la legislación general de seguridad de los productos de consumo, con la norma UNE-EN 14183 como referencia técnica para demostrar que el producto es seguro (Tabla 6).

Documento | Contenido y aplicación al producto | Carácter
Reglamento (UE) 2023/988, de seguridad general de los productos | Aplicable desde el 13/12/2024; deroga la Directiva 2001/95/CE. Obliga a que todo producto de consumo sea seguro, a hacer una evaluación de riesgos documentada y conservarla 10 años, y a identificar al fabricante en el producto. | Obligatorio
Real Decreto Legislativo 1/2007 (Ley General para la Defensa de los Consumidores y Usuarios) | Libro III: responsabilidad civil por daños causados por productos defectuosos (defectos de diseño, de fabricación o de información). | Obligatorio
Real Decreto 1468/1988, Reglamento de etiquetado, presentación y publicidad de los productos industriales | Información mínima obligatoria en el producto o su embalaje para la venta al consumidor: nombre del producto, fabricante o importador, características, instrucciones de uso y advertencias. | Obligatorio
Reglamento (CE) 1907/2006 (REACH) | Restringe sustancias peligrosas en los artículos. Según la entrada 50 del anexo XVII (modificada por el Reglamento (UE) 1272/2013), las partes de caucho o plástico en contacto directo y prolongado con la piel, como los tacos y los recubrimientos antideslizantes, no pueden contener más de 1 mg/kg de cada hidrocarburo aromático policíclico (HAP). | Obligatorio
Ley 7/2022 de residuos y suelos contaminados y RD 1055/2022 de envases | Gestión de residuos y responsabilidad ampliada del productor sobre los envases (caja de cartón). | Obligatorio
Reglamento (UE) 2025/40, de envases y residuos de envases | Publicado el 22/01/2025 y aplicable con carácter general desde el 12/08/2026; deroga la Directiva 94/62/CE. Reducción de envases, contenido reciclable y etiquetado de los materiales del embalaje. | Obligatorio
UNE-EN 14183 Taburetes-escalera | Taburetes de hasta 1 m de altura de plataforma y carga máxima de 150 kg. Define diseño, dimensiones, materiales, ensayos de resistencia y de deslizamiento lateral, y marcado. Peldaños a distancias iguales. Barandilla obligatoria si la plataforma es menor de 24 × 40 cm y está a más de 75 cm. | Voluntaria (referencia)
UNE-EN ISO 7250-1 | Definiciones de las medidas antropométricas básicas del cuerpo humano. | Voluntaria
UNE-EN ISO 14006 y UNE-EN ISO 14040/14044 | Integración del ecodiseño en el proceso de diseño y metodología del análisis de ciclo de vida. | Voluntaria

Tabla 6. Legislación y normativa aplicable. Elaboración propia.

Taburete-escalera plegable, Iván Roig Pérez. Página 13

### 3. ETAPA TÉCNICO-CREATIVA

En esta etapa se buscan soluciones que cumplan los objetivos y el EDP. Se han aplicado dos técnicas de creatividad, un mapa mental para generar ideas sin criticarlas y el método TRIZ para resolver las contradicciones técnicas del producto.

### 3.1. MAPA MENTAL

El mapa mental ordena alrededor del producto las ideas sobre el usuario, la seguridad, el almacenaje, los materiales, la fabricación, la estética, el medio ambiente y el coste (Ilustración 4). Sirve para no olvidar ningún aspecto al generar propuestas.

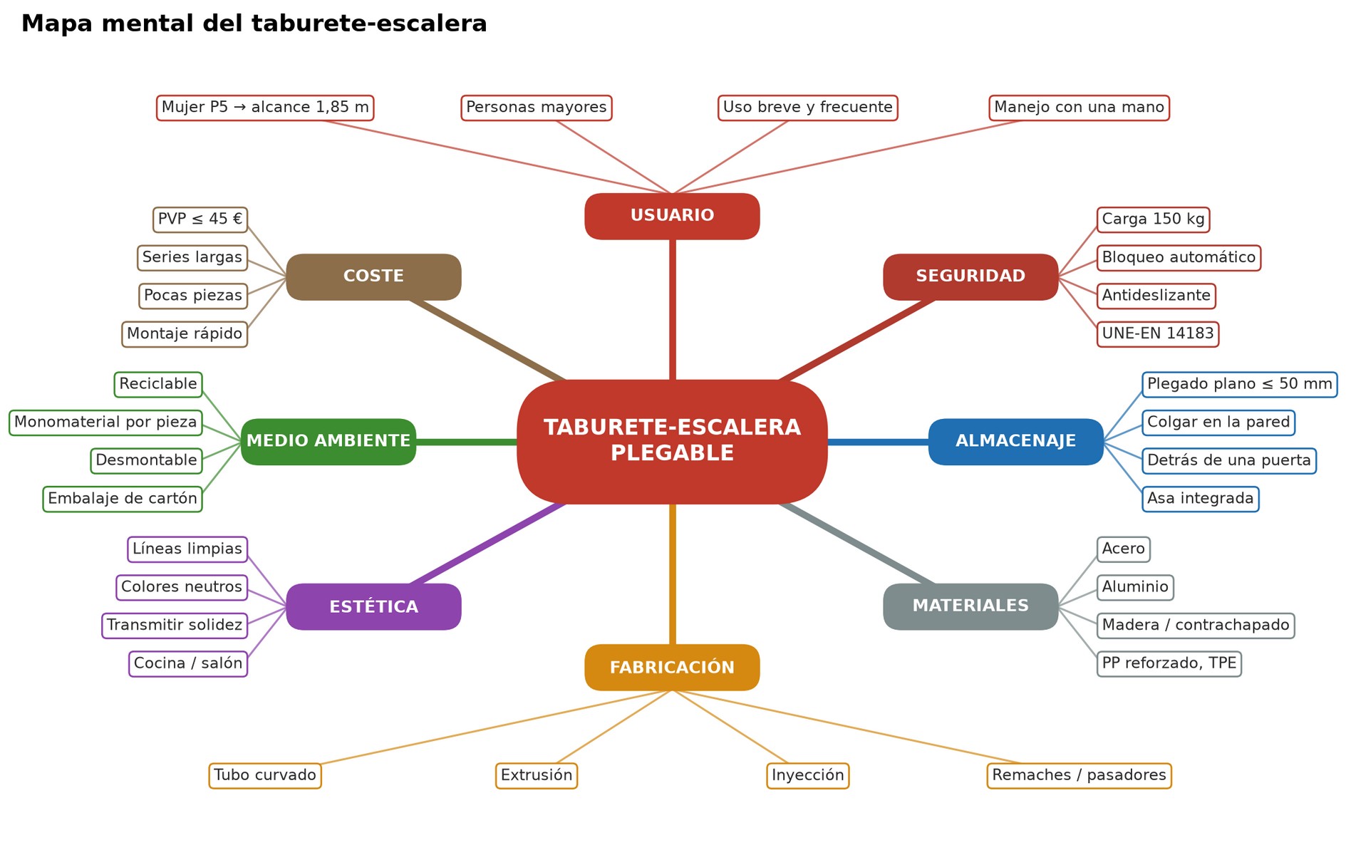
[picture p31: figure]

Ilustración 4. Mapa mental del taburete-escalera. Elaboración propia.

### 3.2. MÉTODO TRIZ

TRIZ (Teoría para Resolver Problemas de Inventiva) lo desarrolló Genrich Altshuller a partir del análisis de miles de patentes. La mayoría de los problemas de diseño aparecen al mejorar un parámetro del producto y empeorar otro, lo que se llama contradicción técnica. Para resolverlas, Altshuller definió 39 parámetros técnicos y 40 principios inventivos, relacionados en la matriz de contradicciones. En la fila se busca el parámetro que se quiere mejorar y en la columna el que empeora, y la celda da los principios más usados para resolver ese conflicto.

CONTRADICCIÓN PRIMERA: RESISTENCIA FRENTE A PESO
Para soportar 150 kg el taburete tiene que ser resistente. Reforzar la estructura con más material o perfiles más gruesos aumenta su peso, y el máximo fijado es de 3,5 kg para poder llevarlo con una mano.

Taburete-escalera plegable, Iván Roig Pérez. Página 14

- Parámetro que se quiere mejorar: 14 (resistencia).
- Parámetro que empeora: 1 (peso del objeto móvil).
- Principios propuestos por la matriz: 1 (segmentación), 8 (contrapeso), 15 (dinamicidad) y 40 (materiales compuestos).

Aplicación de los principios al producto:

- Principio 1, segmentación: dividir la estructura en piezas independientes, cada una con el material y la sección justos para su función (largueros de perfil resistente y peldaños nervados), en lugar de piezas macizas. Facilita la sustitución de piezas y el reciclaje.
- Principio 15, dinamicidad: que los peldaños y la plataforma giren respecto al larguero y queden horizontales para trabajar y verticales para guardar.
- Principio 40, materiales compuestos: usar peldaños de polipropileno reforzado con fibra de vidrio, con nervios interiores, que dan mucha rigidez con poco peso.
- Principio 8, contrapeso: no se ha encontrado una aplicación directa en este producto.

CONTRADICCIÓN SEGUNDA (FÍSICA): BASE GRANDE Y BASE PEQUEÑA
Para ser estable, el taburete necesita una base de apoyo amplia que deje siempre dentro el centro de gravedad del usuario. Para guardarlo, en cambio, tiene que ser lo más pequeño y plano posible. El mismo elemento tiene que ser grande y pequeño, lo que en TRIZ se llama contradicción física.

Las contradicciones físicas se resuelven con los principios de separación. Aquí se aplica la separación en el tiempo, con una base grande cuando se usa y pequeña cuando se guarda. Eso lleva al plegado (principio 15, dinamicidad) y a alojar los peldaños dentro del hueco de los largueros al cerrarlo (principio 7, anidamiento), para no pasar de 50 mm de espesor plegado.

Planteado como contradicción técnica (mejorar el parámetro 13, estabilidad del objeto, empeora el 7, volumen del objeto móvil), la matriz propone los principios 28, 10, 19 y 39. El más útil es el 10 (acción previa), que consiste en dejar el taburete preparado para que al abrirlo quede solo en su posición estable. El 28 (sustitución de sistemas mecánicos), el 19 (acción periódica) y el 39 (atmósfera inerte) no tienen una aplicación clara en este producto.

CONTRADICCIÓN TERCERA: FACILIDAD DE USO FRENTE A FIABILIDAD
Se busca que el taburete se abra y se cierre muy rápido y con una sola mano. Cuanto más fácil sea cerrarlo, mayor es el riesgo de que se cierre accidentalmente con el usuario encima.
- Parámetro que se quiere mejorar: 33 (facilidad de uso).
- Parámetro que empeora: 27 (fiabilidad).
- Principios propuestos por la matriz (celda 33 / 27): 17 (otra dimensión), 27 (objetos baratos de vida corta), 8 (contrapeso) y 40 (materiales compuestos).

Aplicación de los principios al producto:

- Principio 8, contrapeso: sin aplicación directa. En el boceto se pensó en que el peso del usuario mantuviera el taburete abierto. Eso depende de la geometría del mecanismo respecto al punto muerto, que se estudia en el apartado 3.5.

Taburete-escalera plegable, Iván Roig Pérez. Página 15

- Principio 17, otra dimensión: que el pestillo de seguridad se accione en dirección perpendicular al movimiento de plegado, con un deslizador lateral. Un golpe o una carga en el sentido de cierre no puede soltarlo.
- Principio 40, materiales compuestos: ya se aplica en los peldaños de polipropileno reforzado con fibra de vidrio (contradicción primera).
- Principio 27, objetos baratos de vida corta: se descarta por ir en contra del requisito de larga vida útil (R20).
- Principio 10, acción previa, como complemento: el bloqueo se activa solo al abrir el taburete, sin que el usuario haga nada, como en el modelo de utilidad ES 1 070 877 U.

### 3.3. BOCETO INICIAL

Con el mapa mental y las soluciones de TRIZ se ha dibujado el boceto inicial (Ilustración 5), un taburete de tipo tijera con dos peldaños iguales de 240 mm de altura. Los largueros delanteros llevan el peldaño inferior y la plataforma superior, y la pata trasera se articula bajo la plataforma. Un tirante une el peldaño inferior con la pata trasera y bloquea la apertura. Al plegarlo, el peldaño y la plataforma giran hasta quedar verticales entre los largueros, y el conjunto queda en un plano de unos 50 mm de espesor.

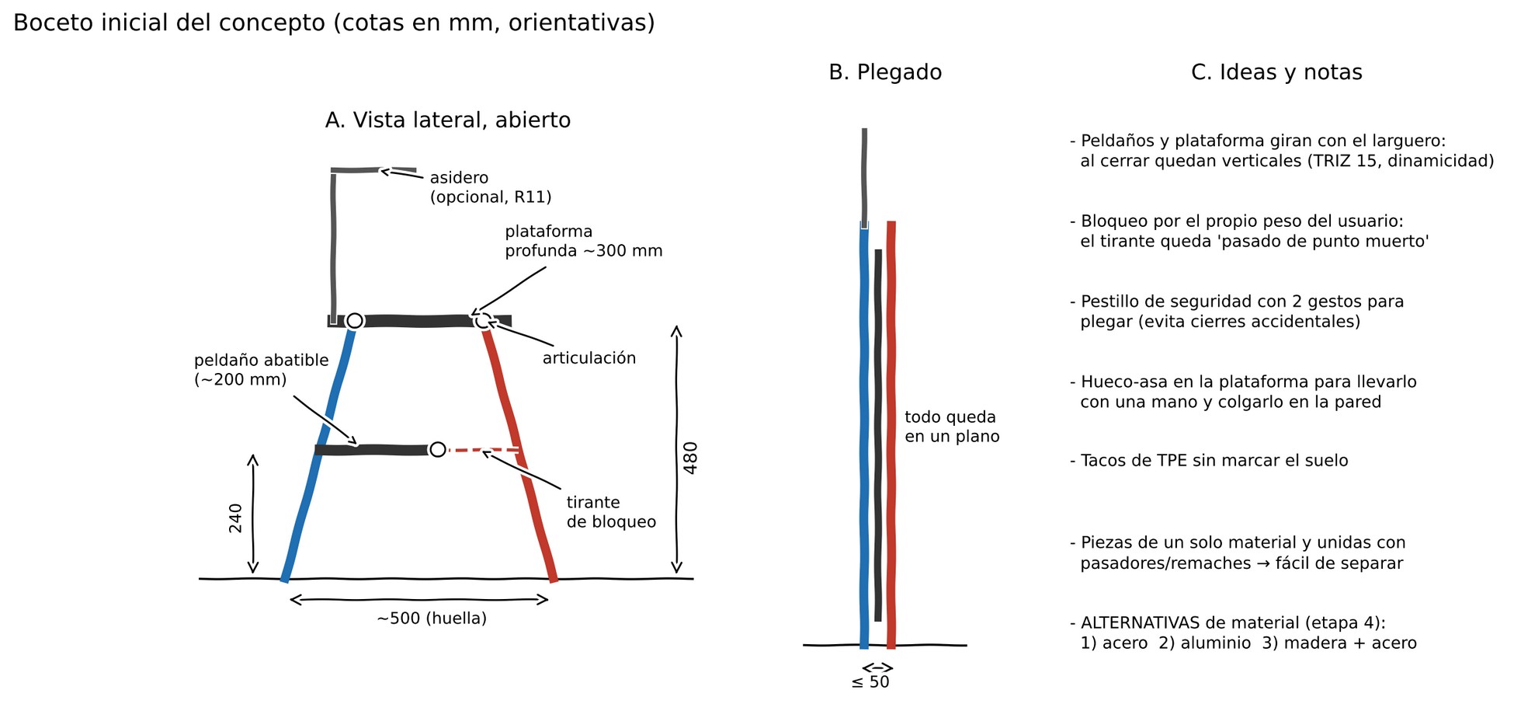
[picture p32: figure]

Ilustración 5. Boceto inicial del concepto. Elaboración propia.
El concepto se ha desarrollado con tres alternativas de material:
- Alternativa 1: largueros y travesaños de tubo rectangular de acero, plataforma y peldaño de chapa de acero de 1,2 mm, y bielas y tirantes de acero.
- Alternativa 2: largueros, travesaños y bielas de perfil extruido de aluminio 6063-T5, y plataforma y peldaño de polipropileno inyectado.
- Alternativa 3: largueros y travesaños de haya maciza, plataforma y peldaño de contrachapado, y bielas y tirantes de acero.

Taburete-escalera plegable, Iván Roig Pérez. Página 16

### 3.4. DISEÑO EN SOLID DEL PRODUCTO FINAL

Con el concepto definido, el producto se ha modelado en SolidWorks. Antes de modelar las piezas definitivas se comprobó el mecanismo de plegado con un estudio cinemático en el plano lateral, y el resultado obligó a modificar el boceto inicial.

REDISEÑO DEL MECANISMO DE PLEGADO
En el boceto la pata trasera giraba bajo la plataforma y un único tirante unía el peldaño con ella. Con esa disposición la plataforma quedaba en voladizo detrás de su articulación y el conjunto no podía plegarse en un plano. La solución adoptada tiene tres partes (Ilustración 6):
- Llevar el pivote de las patas traseras (P) por encima de la plataforma, a 657 mm de altura, prolongando los largueros delanteros hasta unos 780 mm. La prolongación forma un asidero y cumple el requisito deseable R11.
- Articular la plataforma (A) y el peldaño (S) en los largueros delanteros y unirlos a la pata trasera mediante una biela (154 mm) y un tirante (133 mm). Se forman así dos cuadriláteros articulados que comparten la pata trasera.
- Al cerrar la pata trasera (un giro de 41°), las bielas obligan a la plataforma y al peldaño a girar 75° hasta quedar paralelos a los largueros. Con los puntos de unión calculados, plataforma y peldaño quedan alineados con el larguero al plegar.

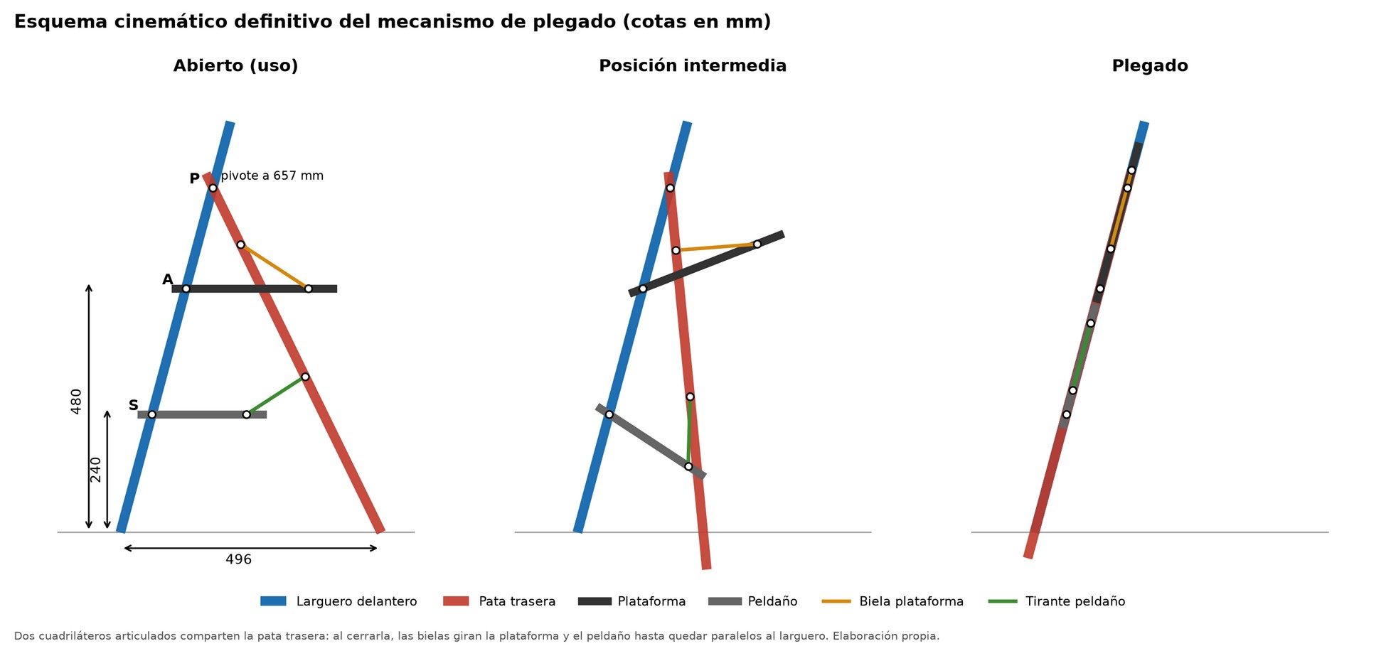
[picture p33: figure]

Ilustración 6. Esquema cinemático definitivo: posiciones abierta, intermedia y plegada. Elaboración propia.
MODELO EN SOLIDWORKS
El modelo de SolidWorks 2026 tiene diez piezas y dos ensamblajes, abierto y plegado (Ilustraciones 7 y 8). Las piezas son el larguero delantero, la pata trasera, el travesaño del asidero, el travesaño trasero, la plataforma, el peldaño, la biela de la plataforma, el tirante del peldaño, el pasador y el taco. Cada pieza tiene una configuración por alternativa de material (ALT1_ACERO, ALT2_ALUMINIO y ALT3_MADERA), en la que cambian el material y, si hace falta, la geometría. En madera los perfiles son macizos y la pared de la plataforma y el peldaño es de 15 mm, frente a 1,2 mm en acero y 3 mm en polipropileno.

Taburete-escalera plegable, Iván Roig Pérez. Página 17

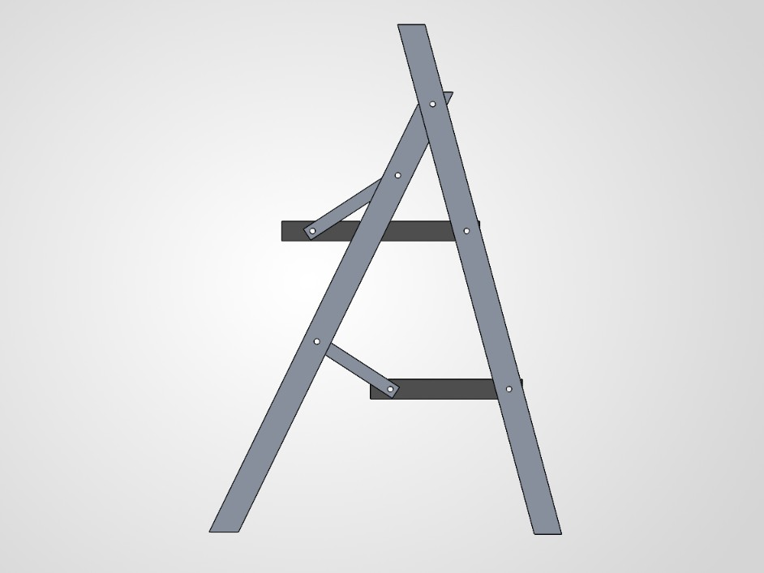
[picture p34: figure]

Ilustración 7. Ensamblaje abierto, vista lateral (SolidWorks). Elaboración propia.

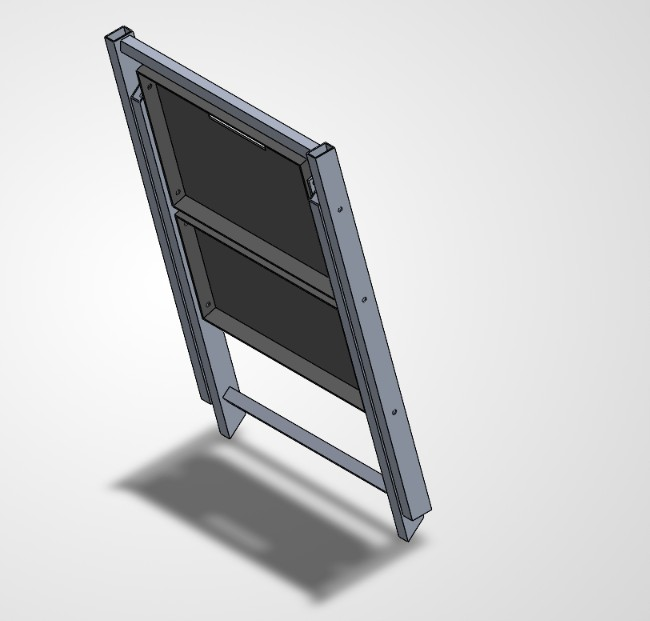
[picture p35: figure]

Ilustración 8. Ensamblaje plegado, vista isométrica (SolidWorks). Elaboración propia.
El modelo confirma las propiedades principales de la etapa inicial. La plataforma está a 480 mm y el peldaño a 240 mm del suelo, y la huella es de 496 × 450 mm. El espesor plegado es de 40 mm, por debajo de los 50 mm de P6, y no hay interferencias entre piezas ni abierto ni plegado. Plegado, las patas traseras sobresalen unos 4 cm por debajo de los largueros, lo que no afecta al guardarlo apoyado en la pared o colgado del asa. Las masas de cada pieza se han calculado con la herramienta de propiedades físicas.

El modelo todavía no incluye el pestillo de seguridad de la contradicción tercera de TRIZ. El mecanismo tiene un único grado de libertad y basta con bloquear una articulación para fijar el taburete abierto. La posición del pestillo, en la articulación del peldaño, y su carga se calculan en el apartado 3.5. Su diseño de detalle queda pendiente.

Taburete-escalera plegable, Iván Roig Pérez. Página 18

### 3.5. COMPROBACIONES DE RESISTENCIA Y ESTABILIDAD

Con cálculos manuales sencillos se ha comprobado que el diseño de la alternativa 2 cumple las propiedades P1 (150 kg) y P2 (estabilidad) y el requisito R3 (no plegarse con el usuario encima). La carga es de 150 kg (1471 N) y el coeficiente de seguridad mínimo, 2 (Tabla 7). Para el aluminio 6063-T5 se ha tomado un límite elástico de 145 MPa (biblioteca de SolidWorks) y para el acero de los pasadores, de 235 MPa. El polipropileno con un 30 % de fibra de vidrio tiene una resistencia de unos 75 MPa (valor típico de catálogo).

Comprobación | Modelo de cálculo | Resultado | C. S. | Conclusión
Larguero delantero | Carga repartida entre los 4 apoyos (368 N por barra); componente transversal en voladizo de 481 mm; tubo 40×20×2 (W = 2223 mm³) | σ = 22 MPa | 6,5 | Cumple
Pandeo del larguero | Euler, L = 481 mm, I mín = 14 379 mm⁴ | Pcr = 42 kN frente a 368 N | > 100 | Cumple
Plataforma de PP sin nervios | Viga biapoyada de 350 mm; carga en una huella de 100 mm; sección en U (tapa de 3 mm y paredes de 30 mm) | σ = 70 MPa | 1,1 | No cumple
Plataforma y peldaño con 3 nervios de 2 mm | Misma viga con 5 almas; + 96 g en total | σ = 37 MPa | 2,0 | Cumple, por poco
Pasadores Ø 8 (articulación de la plataforma) | Toda la carga en los 2 pasadores; cortadura simple | τ = 15 MPa | 9 | Cumple
Aplastamiento del PP en los taladros | 736 N sobre pared de 3 mm | σ = 31 MPa | 2,4 | Poco margen: resalte de 6 mm o casquillo
Vuelco frontal y trasero | Centro de gravedad del usuario a 1,40 m; a 254 mm del apoyo delantero y 242 mm del trasero | Empuje horizontal para volcar: 250 N | - Cumple (estático)
Vuelco lateral | Semiancho de apoyo de las patas traseras: 200 mm | Empuje para volcar: 210 N (14 % del peso) | - Dirección más | desfavorable
Pestillo en la articulación del peldaño | Usuario en el peldaño: momento de cierre 522 N·m; 2 pasadores a 90 mm del pivote | 710 N por pasador; τ = 14 MPa | 9 | Cumple

Tabla 7. Comprobaciones de resistencia y estabilidad de la alternativa 2 (C. S.: coeficiente de seguridad). Elaboración propia.
El resultado más importante es el del mecanismo. Con el modelo cinemático del apartado 3.4 se ha calculado cuánto cambia la altura de la carga si la pata trasera gira 1° con los cuatro pies en el suelo:
- Usuario sobre la plataforma: al abrir 1° más, la plataforma baja 3,9 mm y el peso tiende a abrir el taburete. La apertura queda limitada a 1,9° más, donde el peldaño y el tirante se alinean (punto muerto) y hacen de tope.
- Usuario sobre el peldaño, al subir o bajar: al abrir 1° más, el peldaño sube 6,2 mm y el peso tiende a cerrar el taburete con un momento de unos 522 N·m. El pestillo es imprescindible para cumplir R3. Va en la articulación del peldaño, que es la que más gira (4,1° por cada grado de la pata), y así soporta menos fuerza.

Estas comprobaciones obligan a usar polipropileno con fibra de vidrio, tres nervios en la plataforma y en el peldaño y casquillos en los taladros. Con estos cambios la masa estimada de la alternativa 2 sube de 3,17 a unos 3,46 kg y sigue cumpliendo P5, con poco margen. Si el prototipo pesara más, la pared de los largueros y las patas se puede bajar a 1,5 mm, con un ahorro de unos 0,44 kg. Con esa pared la tensión sería de 29 MPa y el coeficiente de seguridad, de 5.

Taburete-escalera plegable, Iván Roig Pérez. Página 19

### 4. ETAPA DE EVALUACIÓN

En esta etapa se elige una de las tres alternativas de material del apartado 3.3 y se analiza su impacto ambiental con un pequeño análisis de ciclo de vida (ACV) hecho con Eco-it, el programa de las prácticas de la asignatura.
4.1. SELECCIÓN DE LA ALTERNATIVA
Para elegir, se ha comprobado qué alternativas cumplen las propiedades imprescindibles del EDP, ya que un requisito imprescindible no se compensa con una buena nota en otros criterios (Tabla 8). El ACV se ha hecho solo con la alternativa que las cumple todas.
Criterio | Acero | Aluminio + PP | Madera
Peso total, P5 ≤ 3,5 kg (imprescindible) | 9,20 kg: no cumple | 3,17 kg: cumple | 3,96 kg: no cumple
Espesor plegado, P6 ≤ 50 mm | 40 mm: cumple | 40 mm: cumple | 40 mm: cumple
Resistencia a la humedad (cocina y baño) | Necesita pintura | Buena (anodizado y PP) | Necesita barniz
Resultado | Descartada (P5) | Válida | Descartada (P5)
Tabla 8. Comprobación de las alternativas frente a las propiedades imprescindibles del EDP. Elaboración propia.
4.2. METODOLOGÍA Y DATOS DEL ACV
Eco-it es una herramienta de ACV simplificado pensada para diseñadores. El análisis sigue el enfoque “de la cuna a la tumba” de las normas UNE-EN ISO 14040 y 14044, usa la base de datos Ecoindicadores_IHOBE y expresa los resultados como huella de carbono, en kg de CO₂ equivalente. La unidad funcional es un taburete-escalera que permite a un usuario de hasta 150 kg alcanzar 2,30 m de altura durante 10 años de uso doméstico. Eco-it divide el ciclo de vida en tres fases:
- Producción: materiales y procesos de fabricación de cada pieza, con las masas del modelo de SolidWorks, más el transporte de distribución hasta el punto de venta, de 600 km en camión.
- Uso: el producto no consume energía. Eco-it no admite materiales en la fase de uso, y los cuatro tacos de repuesto que se cambian una vez en su vida útil se han incluido en la producción.
- Eliminación: reciclaje del 90 % de los metales (el 10 % restante va a vertedero) e incineración del polipropileno y del caucho.

Se ha calculado una variante con aluminio reciclado en lugar de primario para valorar la mejora propuesta en las conclusiones.

El ACV usa las masas del modelo de SolidWorks (3,17 kg), sin la fibra de vidrio, los nervios y los casquillos del apartado 3.5, que llevan la masa a unos 3,46 kg. El análisis no incluye el embalaje, el anodizado ni las mermas de fabricación, y las bases de datos de Eco-it recogen valores medios.
4.3. RESULTADOS DEL ACV
La alternativa de aluminio es la más ligera, pero el aluminio primario tiene un impacto por kilo muy alto. Los datos se han introducido en Eco-it pieza a pieza (Ilustración 9). La producción es la fase de mayor impacto, con 33 kg CO₂-eq de un total de 35 kg CO₂-eq (Tabla 9 e Ilustración 10). Solo el aluminio primario, 2,29 kg a 12,2 kg CO₂-eq/kg, aporta unos 28 kg CO₂-eq, y 1,86 kg de ese aluminio están en los largueros y las patas traseras. La fase de uso es nula en un producto que no consume energía. La eliminación suma 1,9 kg CO₂-eq por la incineración del polipropileno y del caucho, y el reciclaje de los metales prácticamente no cuenta en esta base de datos.

Taburete-escalera plegable, Iván Roig Pérez. Página 20

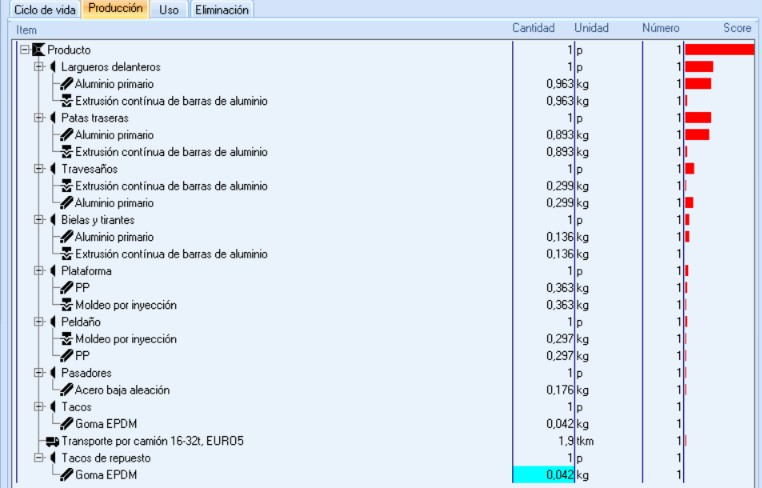
[picture p36: figure]

Ilustración 9. Fase de producción de la alternativa 2 en Eco-it. Elaboración propia.

Fase | Aluminio primario | Aluminio reciclado
Producción (incluye el transporte) | 33 | 8,6
Uso | 0 | 0
Eliminación | 1,9 | 1,9
Total del ciclo de vida | 35 | 10,5
Tabla 9. Resultados de Eco-it de la alternativa 2: aluminio y polipropileno (kg CO₂-eq). Elaboración propia.

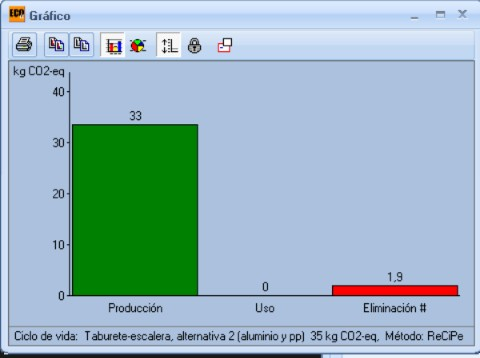
[picture p37: figure]

Ilustración 10. Resultados de Eco-it de la alternativa 2: aluminio y polipropileno. Elaboración propia.
En la variante con aluminio reciclado, las cuatro piezas de aluminio pasan a ser de “Aluminio secundario, a partir de chatarra vieja” y el resto del modelo no cambia. La producción baja de 33 a 8,6 kg CO₂-eq y el total, de 35 a 10,5 kg CO₂-eq, un 70 % menos (Tabla 9 e Ilustración 11). El gráfico de Eco-it muestra este total redondeado a 11 kg CO₂-eq.

Taburete-escalera plegable, Iván Roig Pérez. Página 21

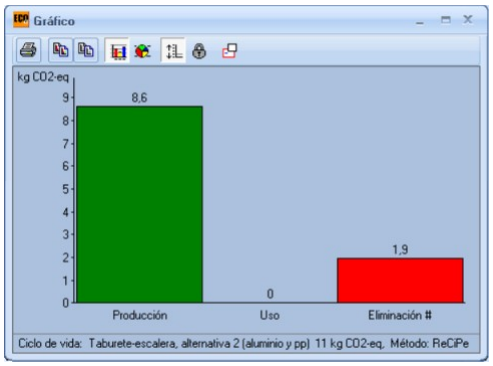
[picture p38: figure]

Ilustración 11. Resultados de Eco-it de la alternativa 2 con aluminio reciclado. Elaboración propia.
4.4. CONCLUSIONES
- Solo la alternativa de aluminio y polipropileno cumple todas las propiedades imprescindibles. Las de acero (9,20 kg) y madera (3,96 kg) superan el peso máximo de 3,5 kg de P5, ligado al requisito imprescindible R10 (llevarlo con una mano), y quedan descartadas.
- En el ACV de la alternativa 2 la fase de producción concentra casi todo el impacto, 33 de los 35 kg CO₂-eq. Las decisiones de diseño con más efecto ambiental son la elección del material y la cantidad empleada.
- El punto débil de la alternativa 2 es el aluminio primario, y por eso se especifica aluminio con alto contenido reciclado. Si todo el aluminio es reciclado, el impacto del ciclo de vida baja de 35 a 10,5 kg CO₂-eq, un 70 % menos.

Se elige la alternativa 2, con perfiles de aluminio 6063-T5 reciclado y plataforma y peldaño de polipropileno reforzado con fibra de vidrio. Es la alternativa modelada en detalle y la que se representa en los planos.

Taburete-escalera plegable, Iván Roig Pérez. Página 22

### 5. ETAPA DE REALIZACIÓN

5.1. PLANOS
La etapa de realización recoge la documentación necesaria para fabricar el producto. Son tres planos en formato A3, que se entregan en el archivo “Anexo_Planos.pdf”. El plano 1 es el conjunto abierto con la lista de piezas y el plano 2, el conjunto plegado con su espesor de 40 mm. El plano 3 es el plano de fabricación del larguero delantero, con material, tolerancias, acabado y proceso.

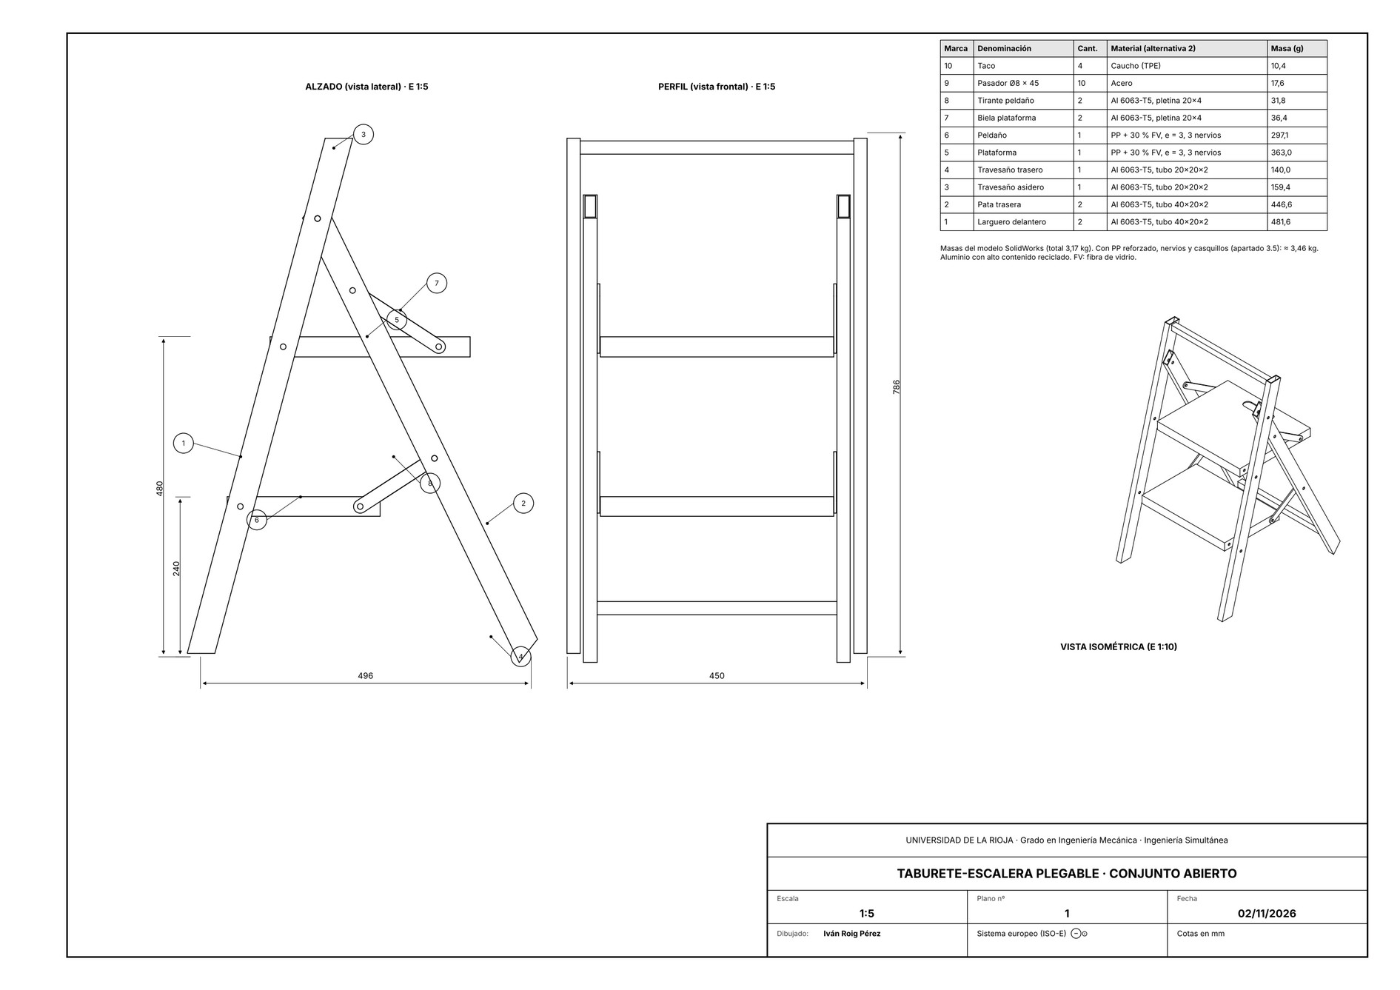
[picture p39: figure]

Plano 1. Conjunto abierto con lista de piezas. Elaboración propia.

Taburete-escalera plegable, Iván Roig Pérez. Página 23

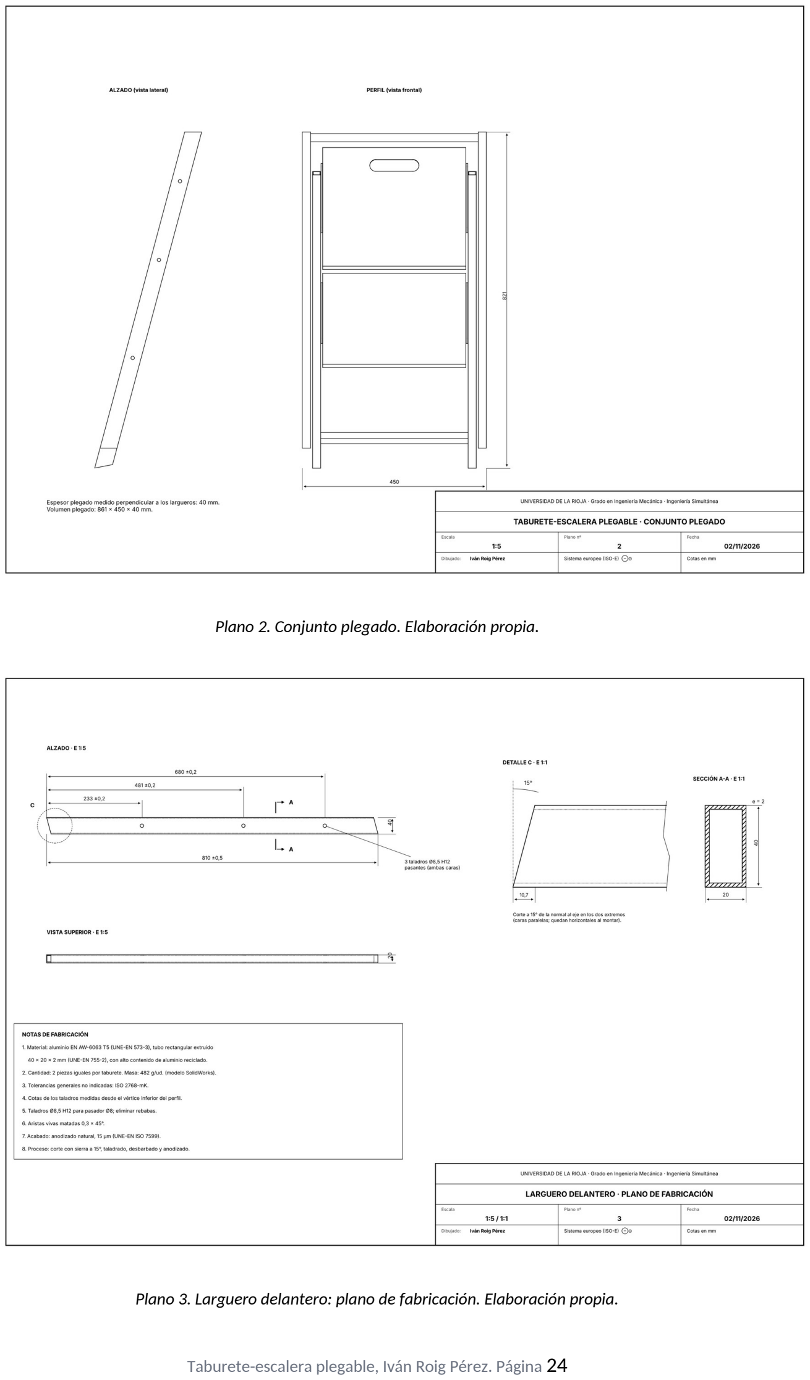
[picture p40: page 24]

Plano 2. Conjunto plegado. Elaboración propia.

Plano 3. Larguero delantero: plano de fabricación. Elaboración propia.

Taburete-escalera plegable, Iván Roig Pérez. Página 24

### BIBLIOGRAFÍA

1. Instituto Nacional de Estadística (INE). Censo Anual de Población. Primeros resultados 2025. https://www.ine.es/dyngs/Prensa/CensoVariables2025.htm
2. Ministerio de Sanidad, Servicios Sociales e Igualdad / Instituto Nacional del Consumo. Red de Detección de Accidentes Domésticos y de Ocio (DADO), informe 2011. https://www.sanidad.gob.es/gabinete/notasPrensa.do?id=2714
3. Carmona Benjumea, A. (2003). Aspectos antropométricos de la población laboral española aplicados al diseño industrial. INSHT, Madrid.
4. INSHT. Datos antropométricos de la población laboral española. 1999.
5. AENOR. UNE-EN 14183: Taburetes-escalera.
6. IKEA España. BEKVÄM taburete escalón, haya. https://www.ikea.com/es/es/p/bekvam-taburete-con-escalon-haya-60178887/
7. IKEA. BOLMEN taburete escalón. https://www.ikea.com/es/es/p/bolmen-taburete-escalon-blanco-70574429/
8. Obramat. Taburete de aluminio 2 peldaños. https://www.obramat.es/productos/taburete-de-aluminio-2-peldanos-10455151.html
9. ManoMano. Hailo 4396-901 Taburete de acero K20 (2 peldaños). https://www.manomano.es/p/hailo-4396-901---taburete-de-acero-k20-2-peldaos-37584210
10. Comercial Pazos. Hailo 4442-701 Taburete de aluminio L90. https://comercialpazos.com/hailo-4442-701-taburete-de-aluminio-l90-stepke-2x2-peldanos
11. Leroy Merlin. Taburete plegable doméstico de acero - 2 peldaños. https://www.leroymerlin.es/productos/taburete-plegable-domestico-de-acero-2-peldanos-88754256.html
12. Google Patents. ES1070877U, US6454050B2, US6966404B2, US12419421B2. https://patents.google.com
13. Test and Research Centre. Step Ladders vs. Step Stools: understanding EN 131 and EN 14183. https://testandresearch.org/step-ladders-vs-step-stools-understanding-en-131-and-en-14183/
14. AFESPO. EN 14183, normativa obligatoria de los taburetes. https://www.afespo.com/en-14183-normativa-obligatoria-de-taburetes/
15. Reglamento (UE) 2023/988 del Parlamento Europeo y del Consejo, relativo a la seguridad general de los productos. https://eur-lex.europa.eu/legal-content/es/ALL/?uri=CELEX:32023R0988

Taburete-escalera plegable, Iván Roig Pérez. Página 25

16. Altshuller, G. Matriz de contradicciones y 40 principios inventivos. Herramienta TRIZ40: https://www.triz40.com
17. Sanz Adán, F. Apuntes de Ingeniería Simultánea: Metodologías, EDP, Patentes, Ecodiseño, Técnicas de evaluación. Universidad de La Rioja.
18. Pheasant, S. y Haslegrave, C. M. (2006). Bodyspace: Anthropometry, Ergonomics and the Design of Work. 3.ª ed. CRC Press.
19. Reglamento (UE) n.º 1272/2013 de la Comisión, por el que se modifica el anexo XVII de REACH en relación con los HAP. https://www.boe.es/buscar/doc.php?id=DOUE-L-2013-82738
20. Reglamento (UE) 2025/40, sobre los envases y residuos de envases. https://www.boe.es/buscar/doc.php?id=DOUE-L-2025-80087
21. Real Decreto 1468/1988, de 2 de diciembre. https://www.boe.es/buscar/act.php?id=BOE-A-1988-28089
22. USPTO. US 12,419,421 B2, Foldable locking step stool (2025). https://image-ppubs.uspto.gov/dirsearch-public/print/downloadPdf/12419421
23. OEPM. ES 1 070 877 U, Dispositivo de enclavamiento para taburetes plegables y similares (2009).
24. UNE-EN ISO 14040:2006 y UNE-EN ISO 14044:2006. Gestión ambiental. Análisis del ciclo de vida.
25. PRé Sustainability. Eco-it (EcoIt): software de análisis de ciclo de vida simplificado para diseñadores. Material de prácticas de la asignatura.

Taburete-escalera plegable, Iván Roig Pérez. Página 26
