ivanroigperez/prueba/trabajo/acv/figura_acv_fases.png

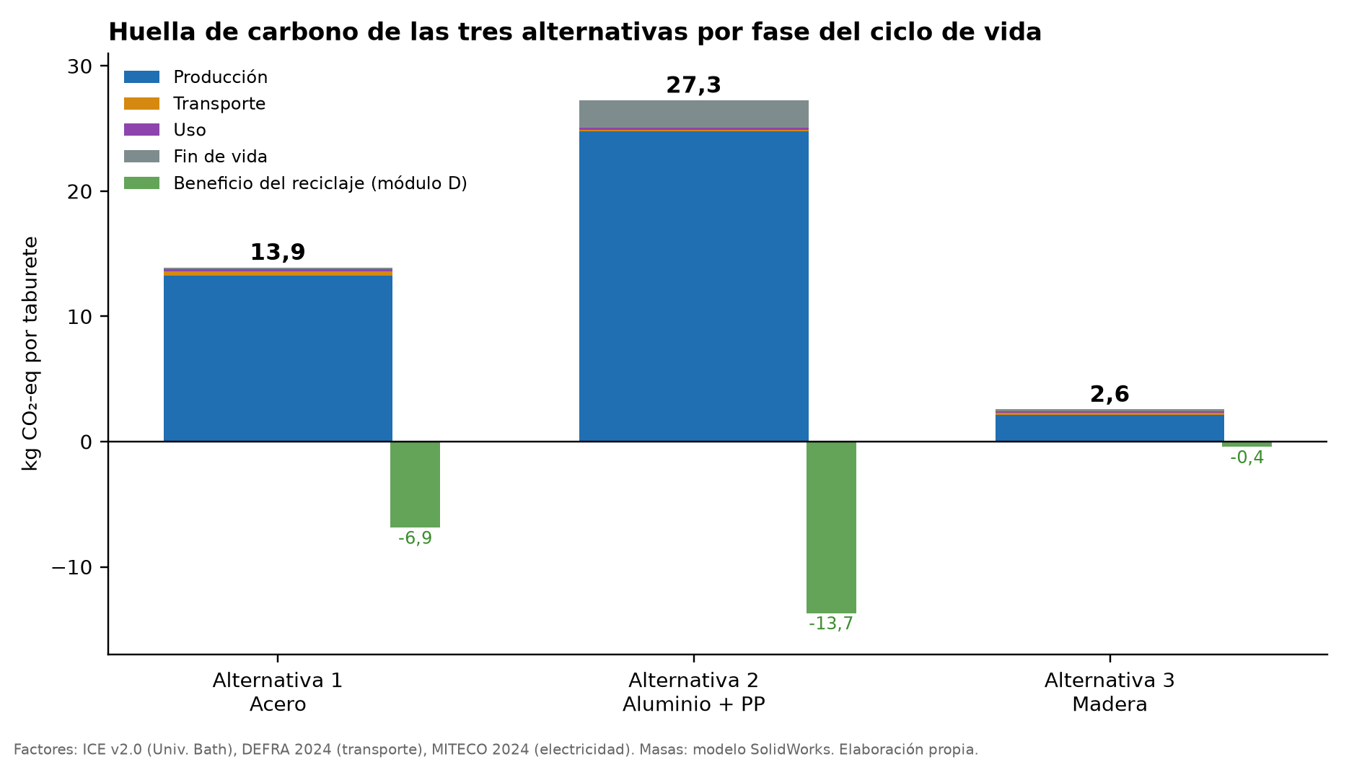
trabajo/acv/figura_acv_fases.png
