ivanroigperez/prueba/trabajo/cad/plano3_larguero_pata.png

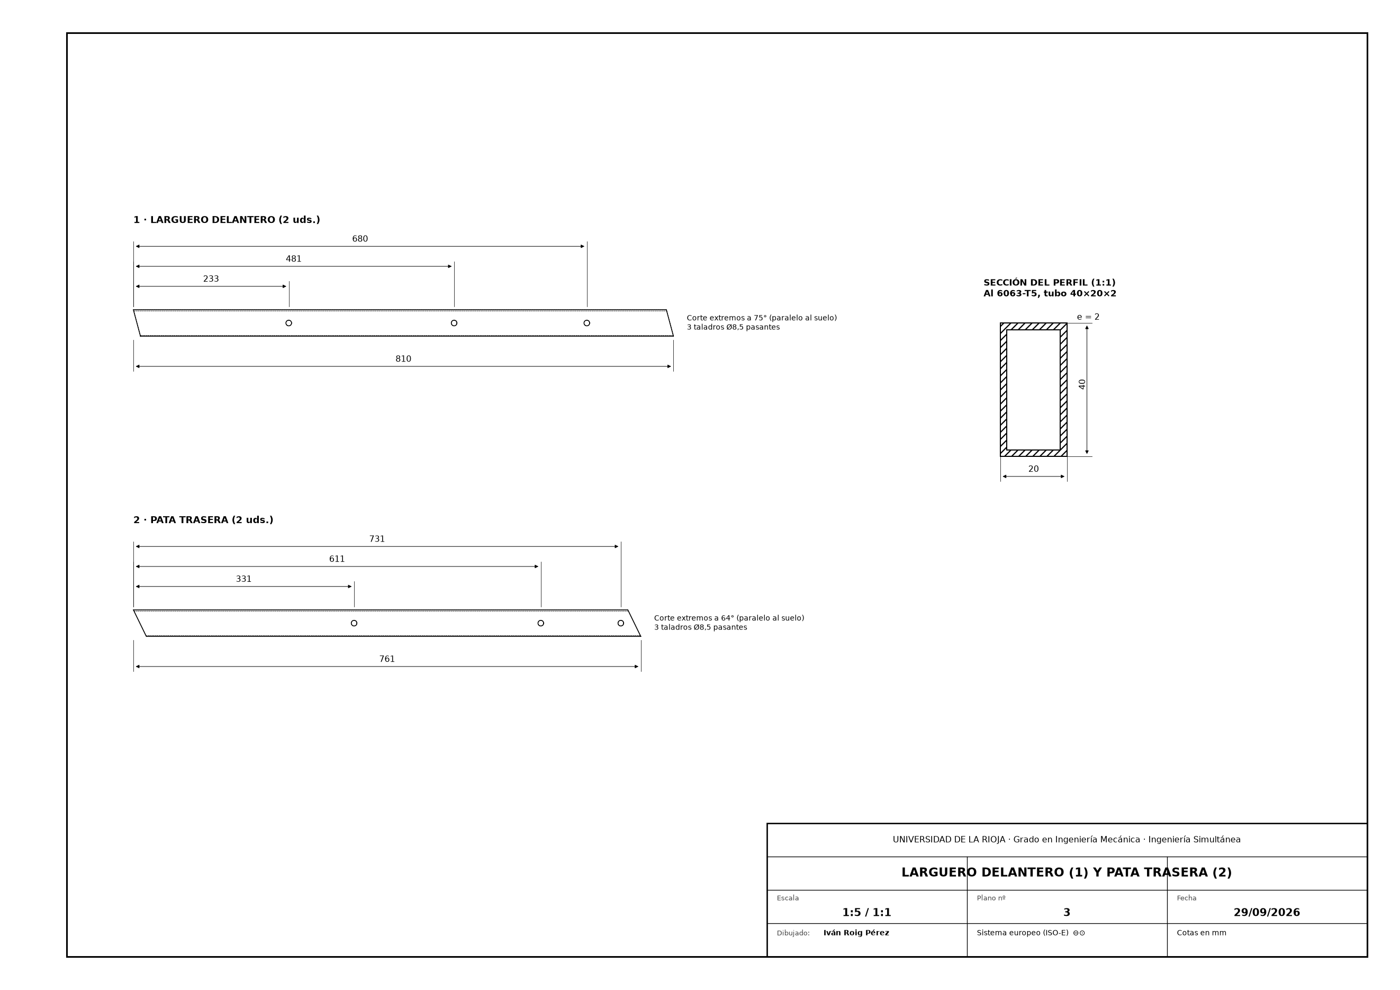
trabajo/cad/plano3_larguero_pata.png
