ivanroigperez/prueba/trabajo/cad/plano4_plataforma_peldano.png

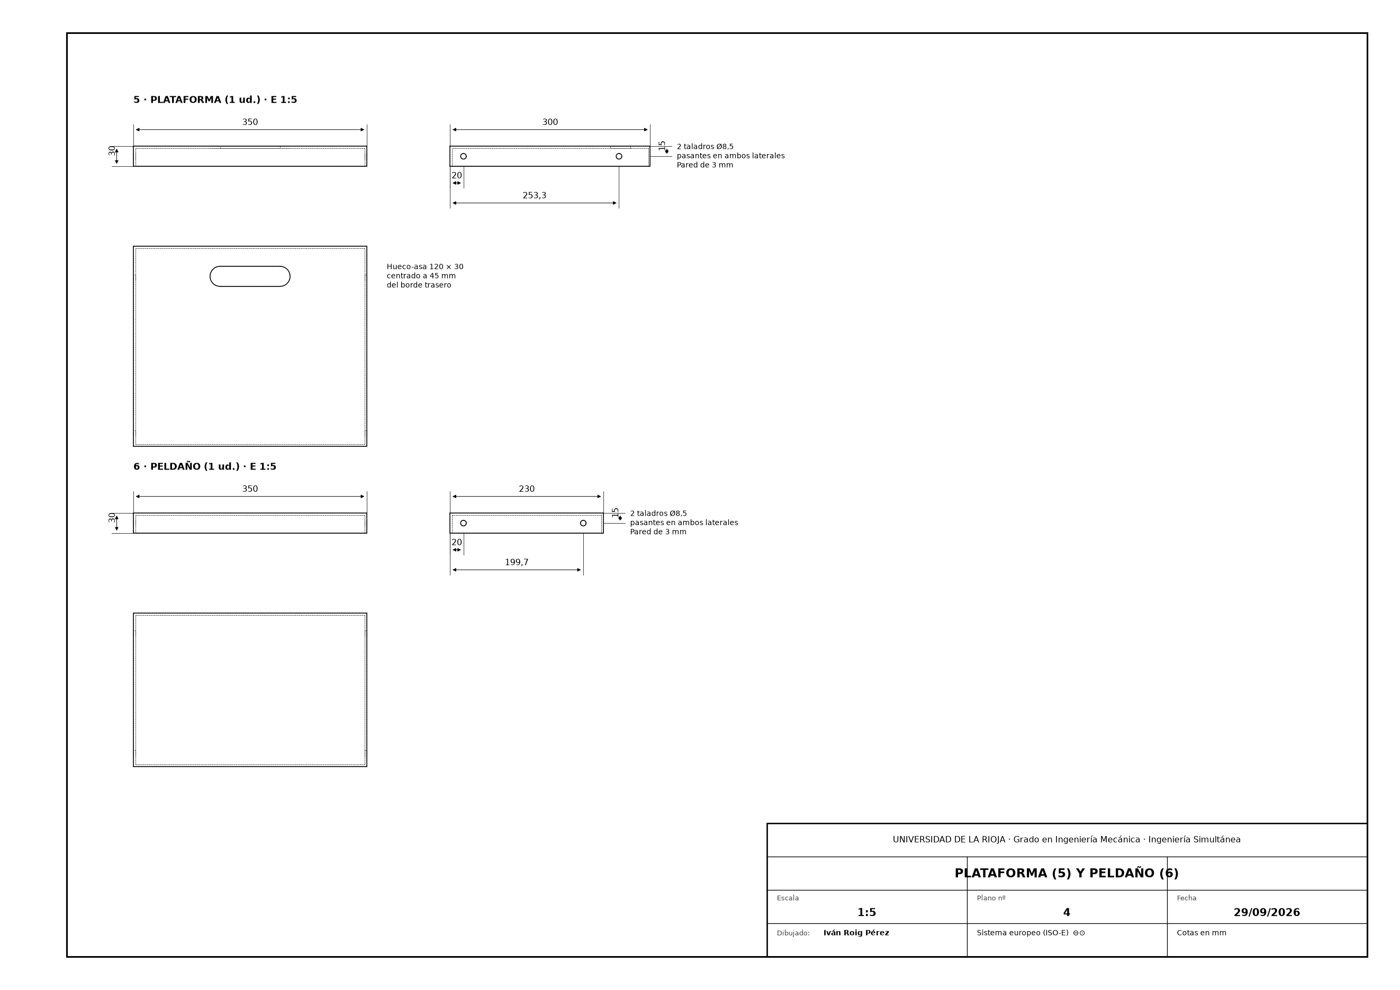
trabajo/cad/plano4_plataforma_peldano.png
