ivanroigperez/prueba/trabajo/cad/plano5_piezas_varias.png

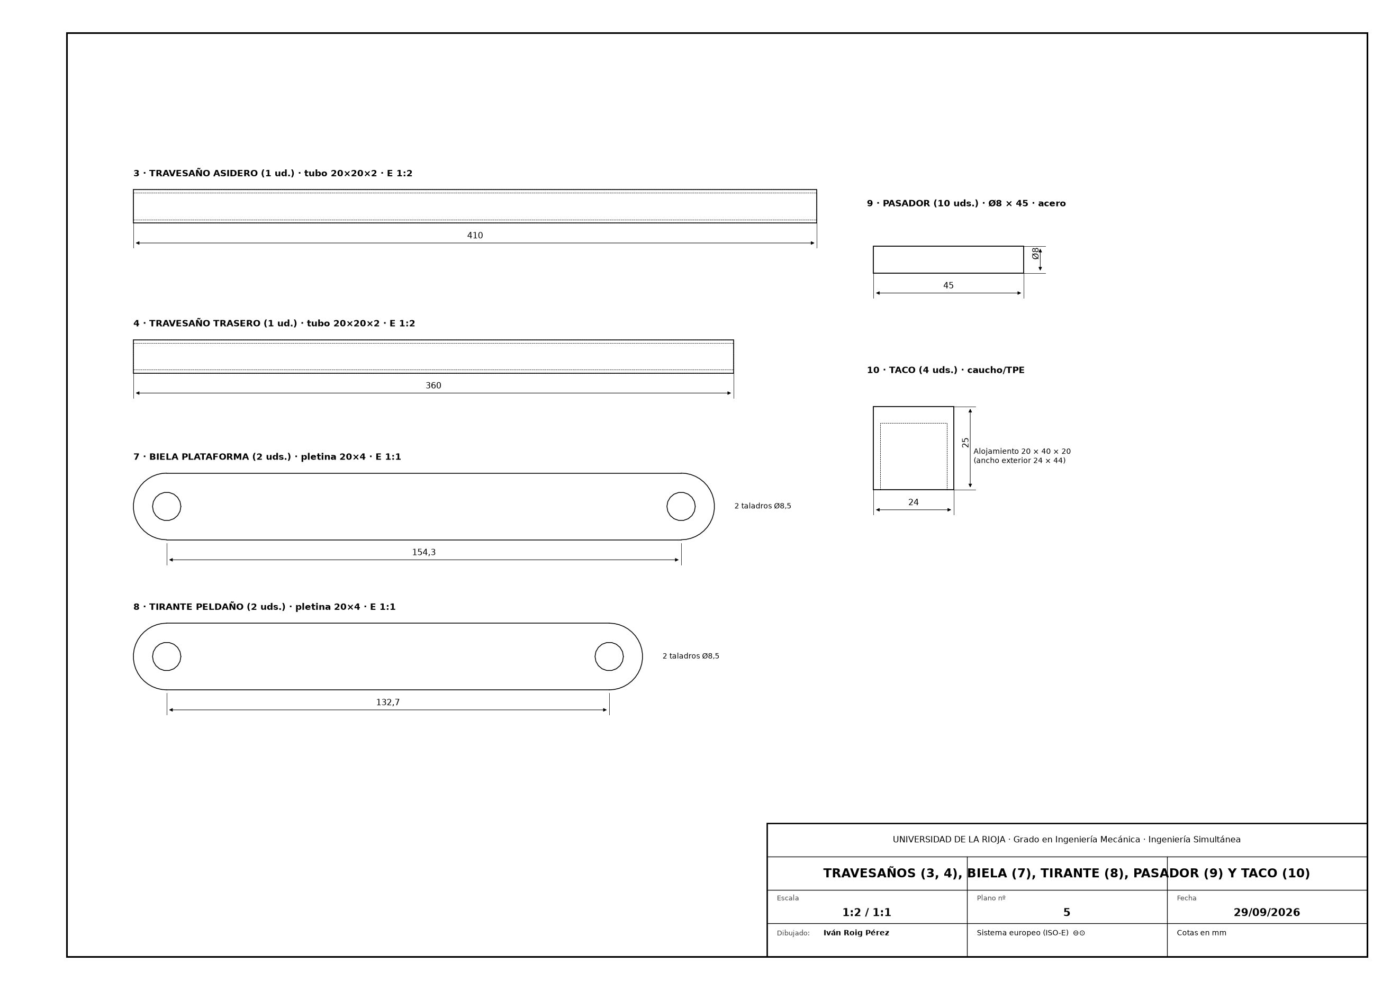
trabajo/cad/plano5_piezas_varias.png
