ivanroigperez/prueba/trabajo/cad/vista_conjunto.png

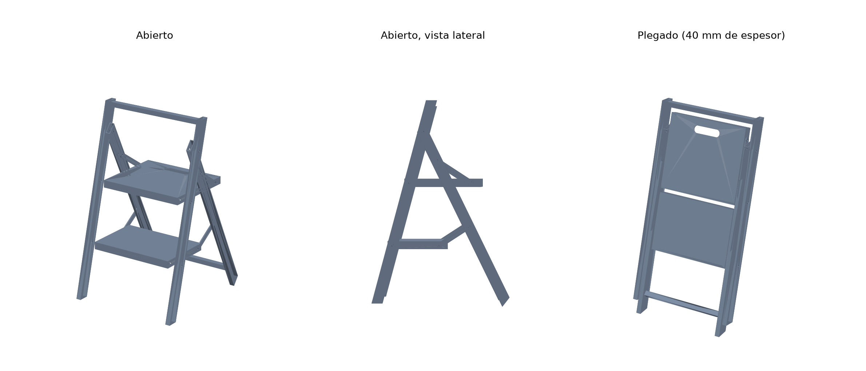
trabajo/cad/vista_conjunto.png
