ivanroigperez/prueba/trabajo/capturas/sw_frontal_plegado.png

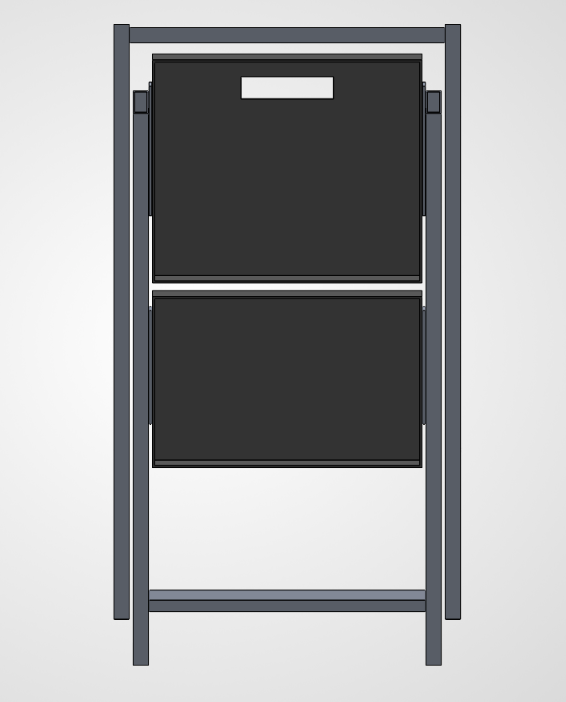
trabajo/capturas/sw_frontal_plegado.png
