ivanroigperez/prueba/trabajo/cad/masas_solidworks.csv

Pieza | Cantidad | Masa ALT1_ACERO (g) | Masa ALT2_ALUMINIO (g) | Masa ALT3_MADERA (g)
Larguero_delantero | 2 | 1391,2 | 481,6 | 356,2
Pata_trasera | 2 | 1290,2 | 446,6 | 330,3
Travesano_asidero | 1 | 460,5 | 159,4 | 91,8
Travesano_trasero | 1 | 404,4 | 140,0 | 80,6
Plataforma | 1 | 1296,1 | 363,0 | 997,8
Peldano | 1 | 1062,8 | 297,1 | 802,7
Biela_plataforma | 2 | 105,2 | 36,4 | 105,2
Tirante_peldano | 2 | 91,7 | 31,8 | 91,7
Pasador | 10 | 17,6 | 17,6 | 17,6
Taco | 4 | 10,4 | 10,4 | 10,4
