ivanroigperez/prueba/trabajo/acv/figura_acv_componentes.png

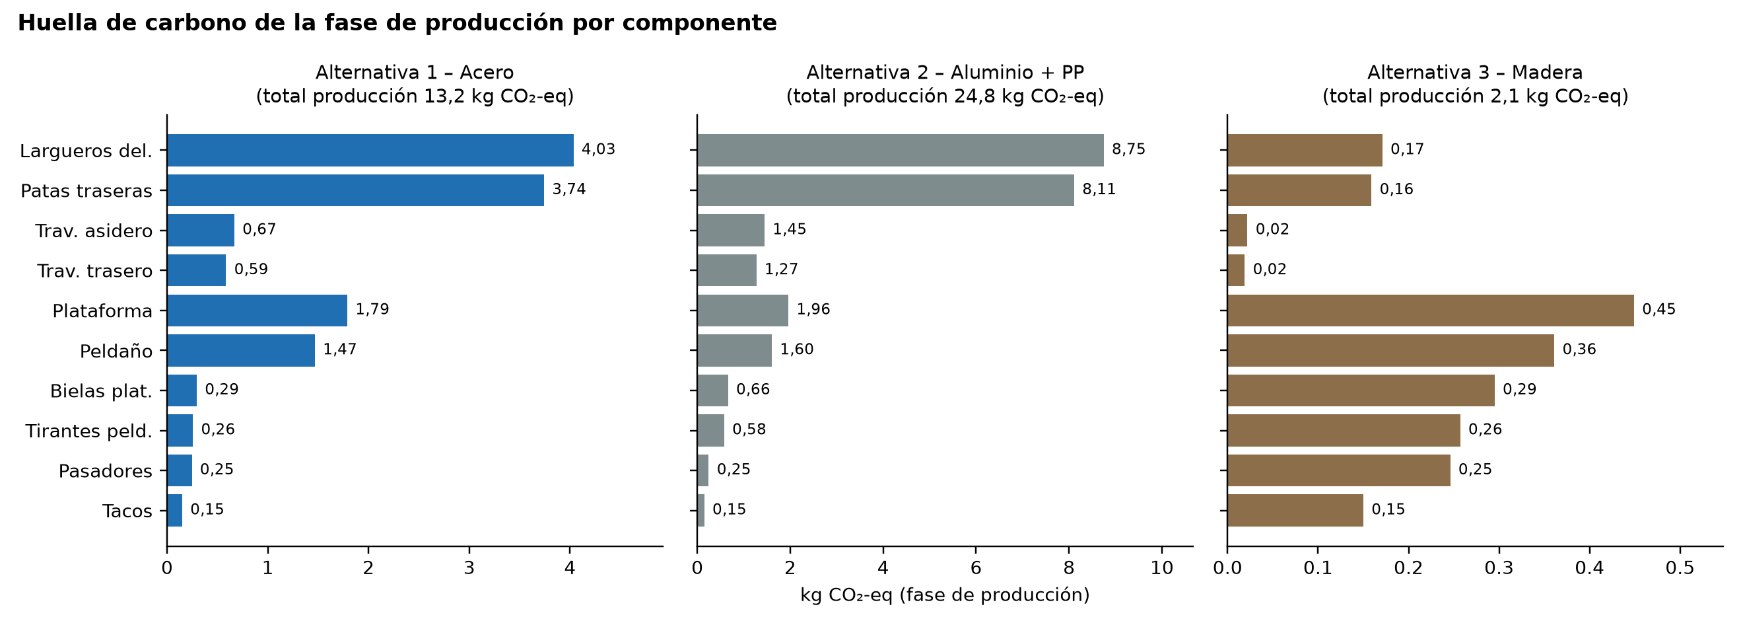
trabajo/acv/figura_acv_componentes.png
