ivanroigperez/prueba/trabajo/cad/conjunto_plegado.step

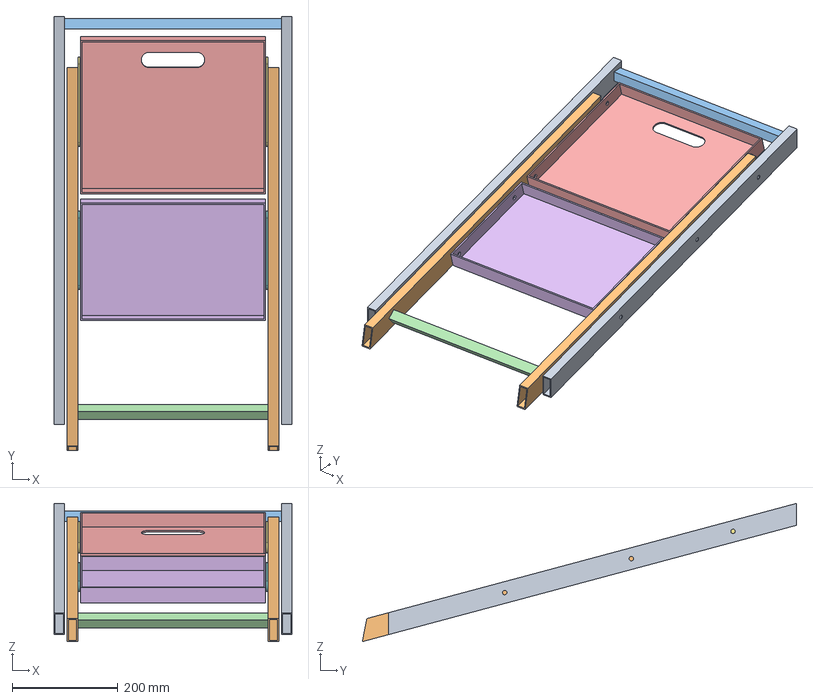
[picture p62: CAD file, 2026-09-29]
trabajo/cad/conjunto_plegado.step
450.0 x 821.3 x 261.5 mm
