ivanroigperez/prueba/trabajo/cad/step/tirante_peldano.step

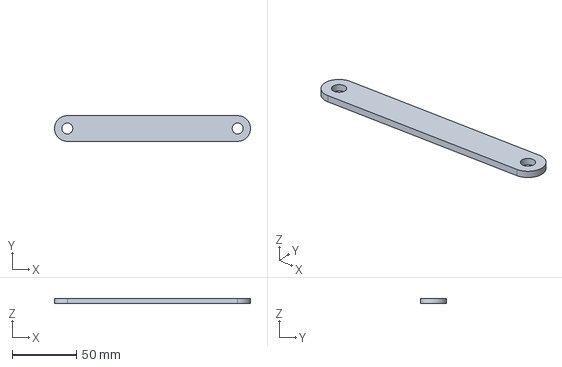
[picture p63: CAD file, 2026-09-29]
trabajo/cad/step/tirante_peldano.step
152.7 x 20.0 x 4.00 mm
