ivanroigperez/prueba/trabajo/portada/step/travesano_asidero.step

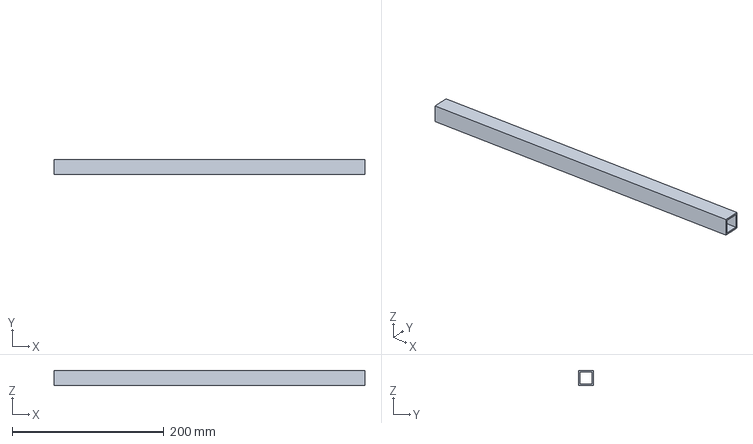
[picture p64: CAD file, 2026-09-29]
trabajo/portada/step/travesano_asidero.step
410.0 x 20.0 x 20.0 mm
