ivanroigperez/prueba/trabajo/cad/conjunto_abierto.step

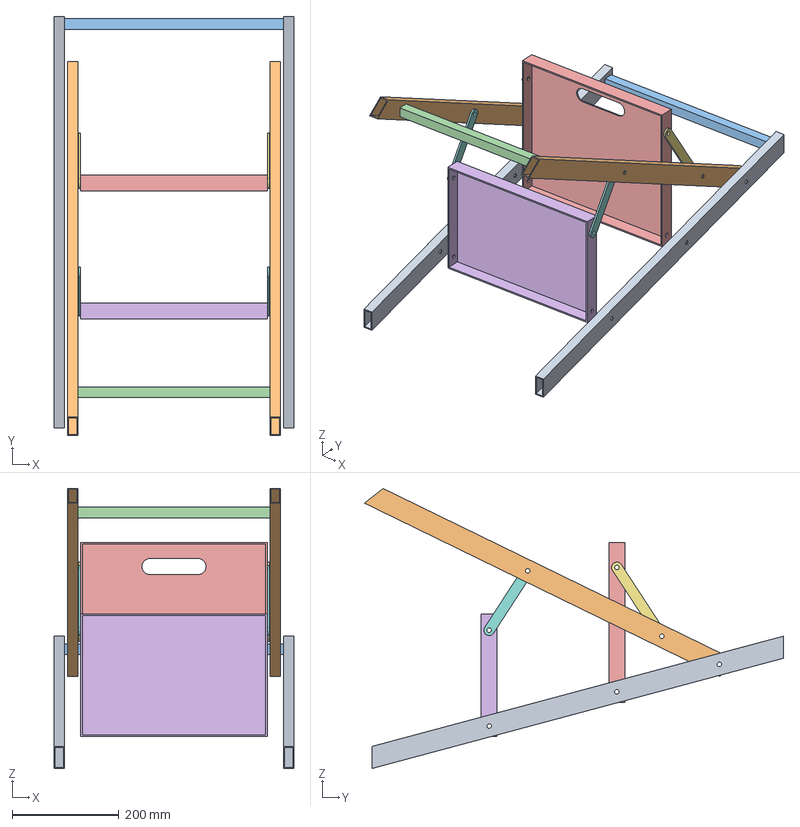
[picture p65: CAD file, 2026-09-29]
trabajo/cad/conjunto_abierto.step
450.0 x 786.2 x 525.2 mm
