ivanroigperez/prueba/trabajo/cad/step/travesano_trasero.step

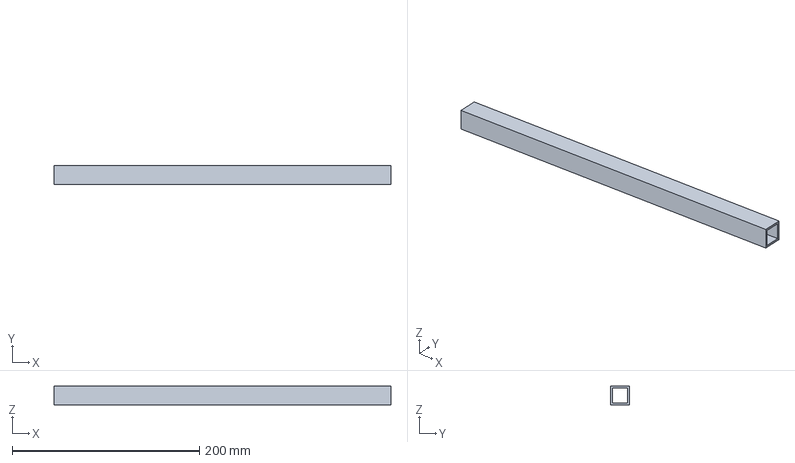
[picture p66: CAD file, 2026-09-29]
trabajo/cad/step/travesano_trasero.step
360.0 x 20.0 x 20.0 mm
