ivanroigperez/prueba/trabajo/portada/step/pasador.step

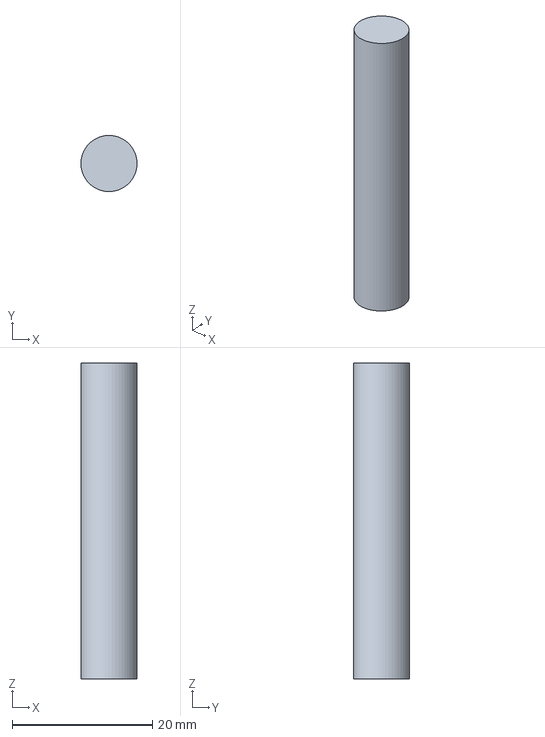
[picture p67: CAD file, 2026-09-29]
trabajo/portada/step/pasador.step
7.99 x 8.00 x 45.0 mm
