ivanroigperez/prueba/trabajo/cad/step/larguero_delantero.step

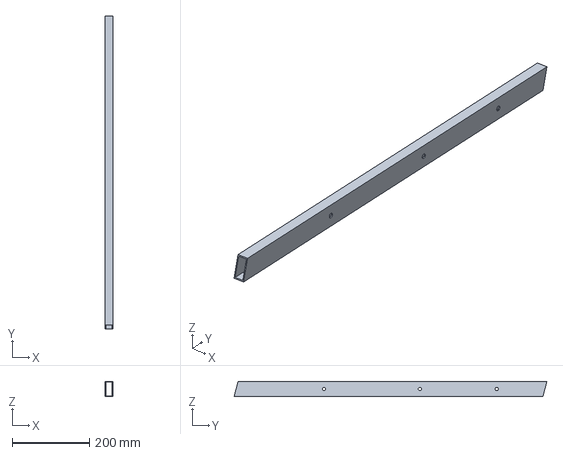
[picture p68: CAD file, 2026-09-29]
trabajo/cad/step/larguero_delantero.step
20.0 x 810.0 x 40.0 mm
