ivanroigperez/prueba/trabajo/portada/step/taco.step

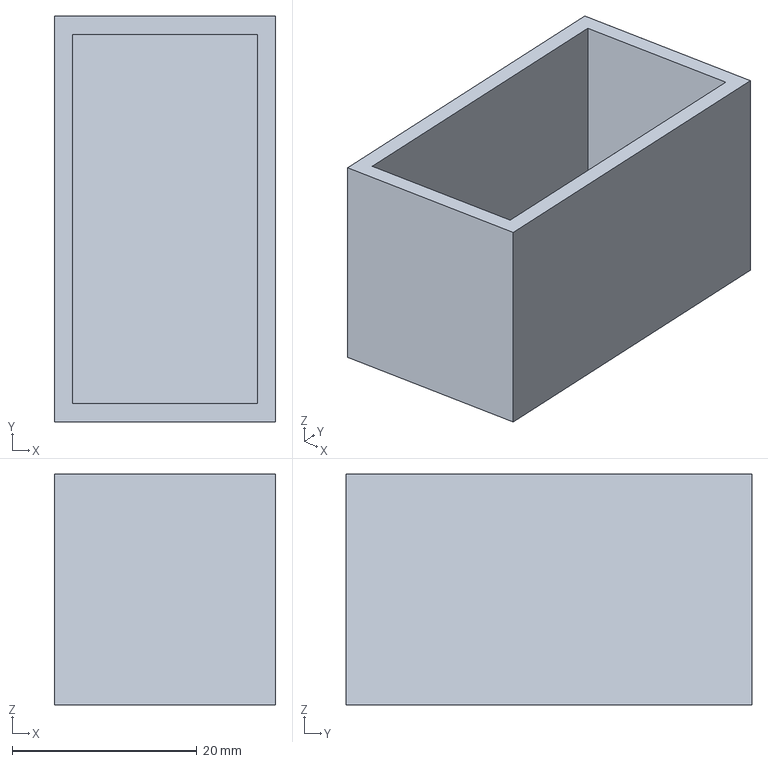
[picture p69: CAD file, 2026-09-29]
trabajo/portada/step/taco.step
24.0 x 44.0 x 25.0 mm
