ivanroigperez/prueba/trabajo/portada/step/pata_trasera.step

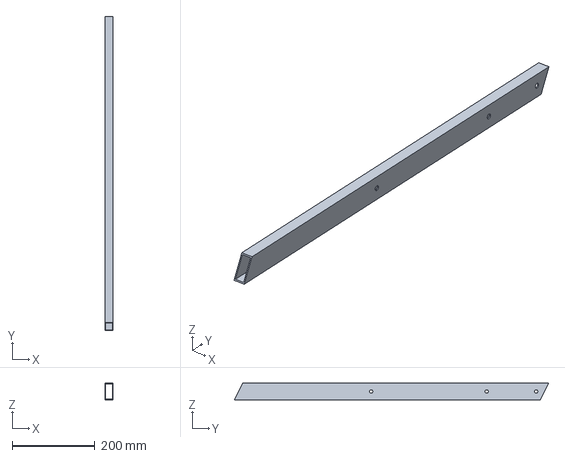
[picture p70: CAD file, 2026-09-29]
trabajo/portada/step/pata_trasera.step
20.0 x 761.0 x 40.0 mm
