ivanroigperez/prueba/trabajo/portada/step/plataforma.step

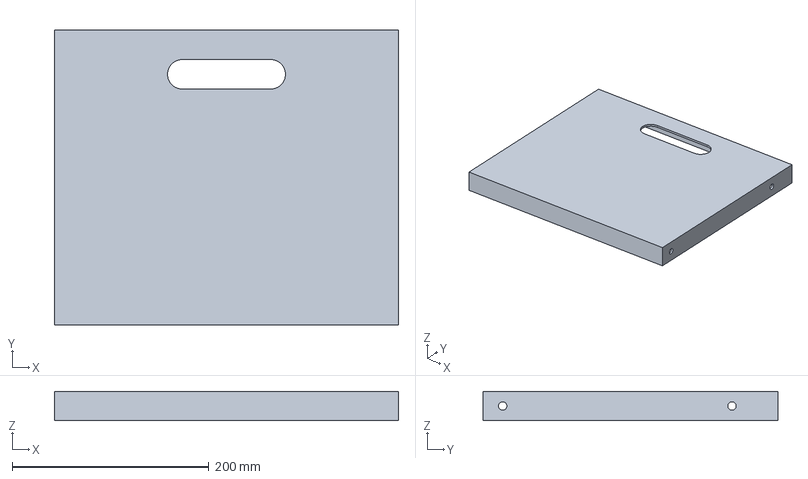
[picture p71: CAD file, 2026-09-29]
trabajo/portada/step/plataforma.step
350.0 x 300.0 x 30.0 mm
