ivanroigperez/prueba/trabajo/portada/step/peldano.step

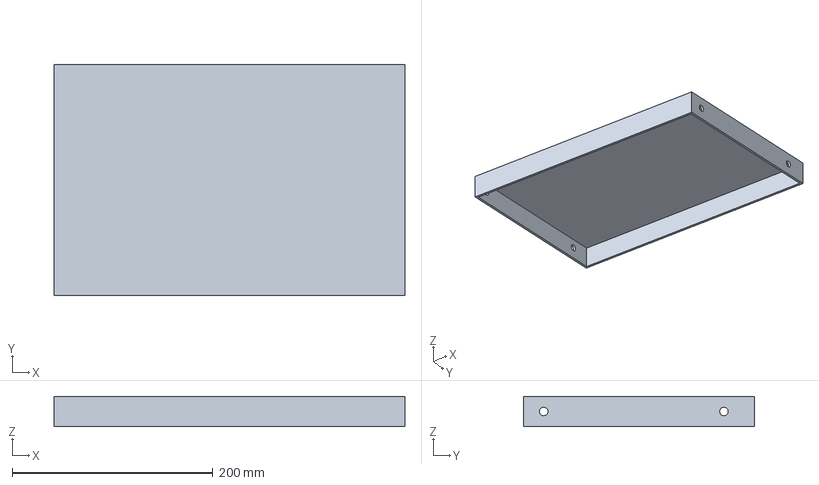
[picture p72: CAD file, 2026-09-29]
trabajo/portada/step/peldano.step
350.0 x 230.0 x 30.0 mm
