ivanroigperez/prueba/trabajo/portada/step/biela_plataforma.step

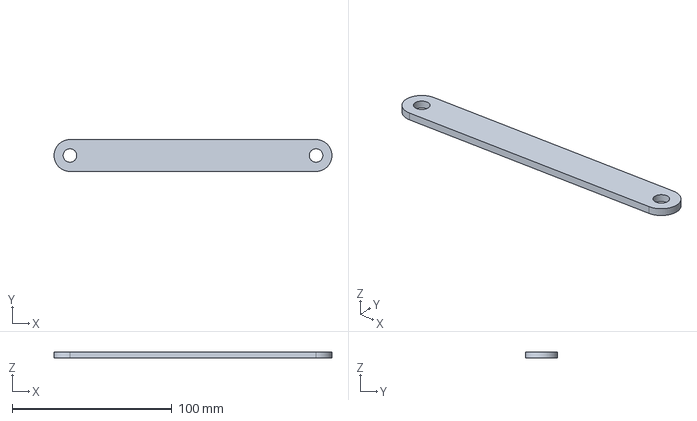
[picture p73: CAD file, 2026-09-29]
trabajo/portada/step/biela_plataforma.step
174.3 x 20.0 x 4.00 mm
