ivanroigperez/prueba/(list of files, cad)

Other CAD files:
trabajo/portada/step/travesano_trasero.step
trabajo/portada/step/tirante_peldano.step
trabajo/portada/step/larguero_delantero.step
trabajo/cad/conjunto_abierto.stl
trabajo/cad/conjunto_plegado.stl
trabajo/portada/step/biela_plataforma.stl
trabajo/portada/step/larguero_delantero.stl
trabajo/portada/step/pasador.stl
trabajo/portada/step/pata_trasera.stl
trabajo/portada/step/peldano.stl
trabajo/portada/step/plataforma.stl
trabajo/portada/step/taco.stl
trabajo/portada/step/tirante_peldano.stl
trabajo/portada/step/travesano_asidero.stl
trabajo/portada/step/travesano_trasero.stl
