ivanroigperez/prueba/entrega/Anexo_Planos.pdf

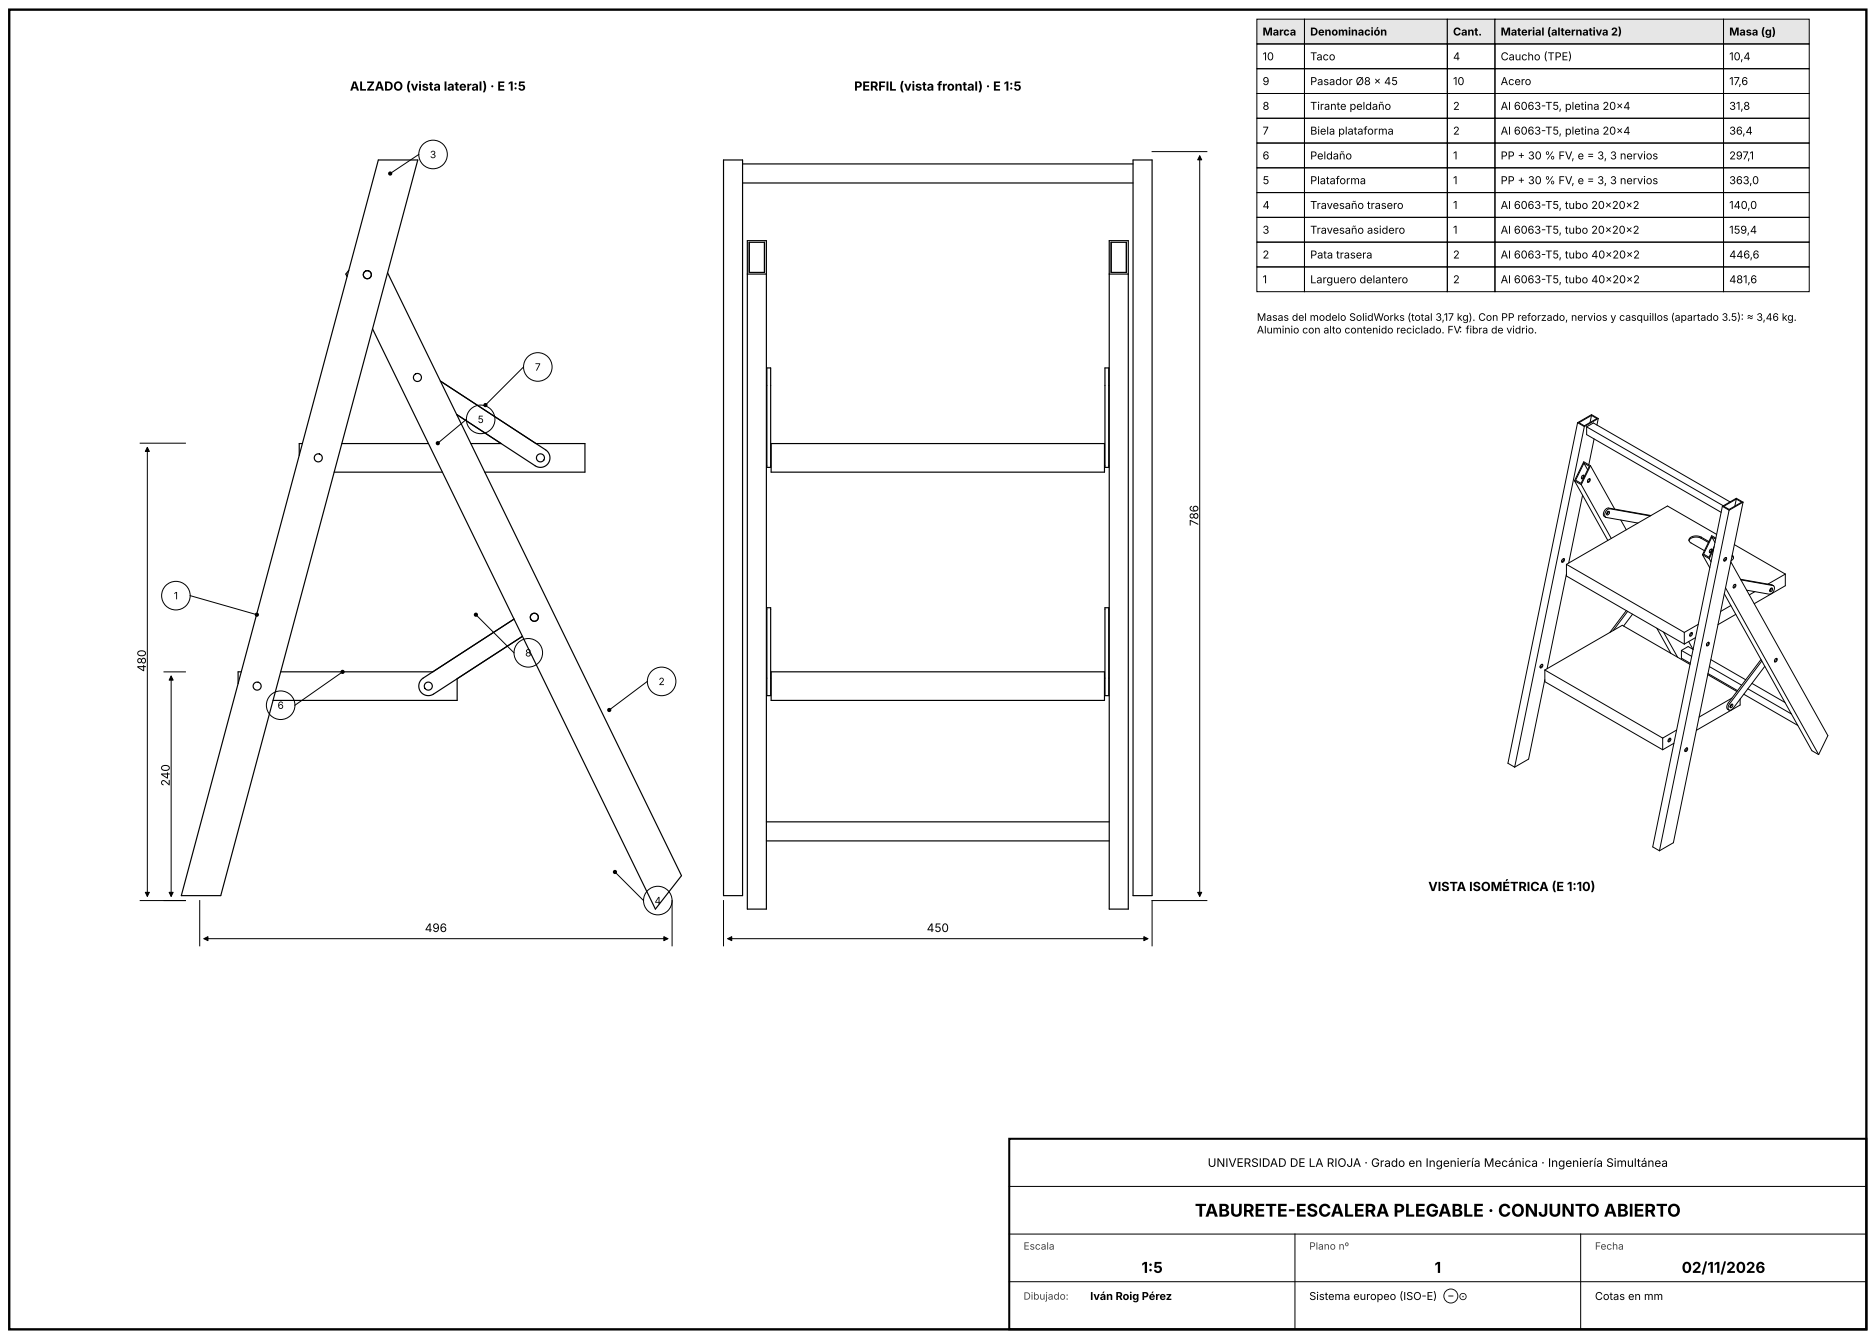
[picture p74: page 1]
Escala; Plano nº; Fecha; Dibujado:; Iván Roig Pérez; Sistema europeo (ISO-E) ⊖⊙; Cotas en mm; ALZADO (vista lateral) · E 1:5; PERFIL (vista frontal) · E 1:5; VISTA ISOMÉTRICA (E 1:10); Marca; Denominación; Cant.; Material (alternativa 2); Masa (g); Taco; Caucho (TPE); Pasador Ø8 × 45; Acero; Tirante peldaño; Al 6063-T5, pletina 20×4; Biela plataforma; Peldaño; PP + 30 % FV, e = 3, 3 nervios; Plataforma; Travesaño trasero; Al 6063-T5, tubo 20×20×2; Travesaño asidero; Pata trasera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

Masas del modelo SolidWorks (total 3,17 kg). Con PP reforzado, nervios y casquillos (apartado 3.5): ≈ 3,46 kg.
Aluminio con alto contenido reciclado. FV: fibra de vidrio.

UNIVERSIDAD DE LA RIOJA · Grado en Ingeniería Mecánica · Ingeniería Simultánea

TABURETE-ESCALERA PLEGABLE · CONJUNTO ABIERTO

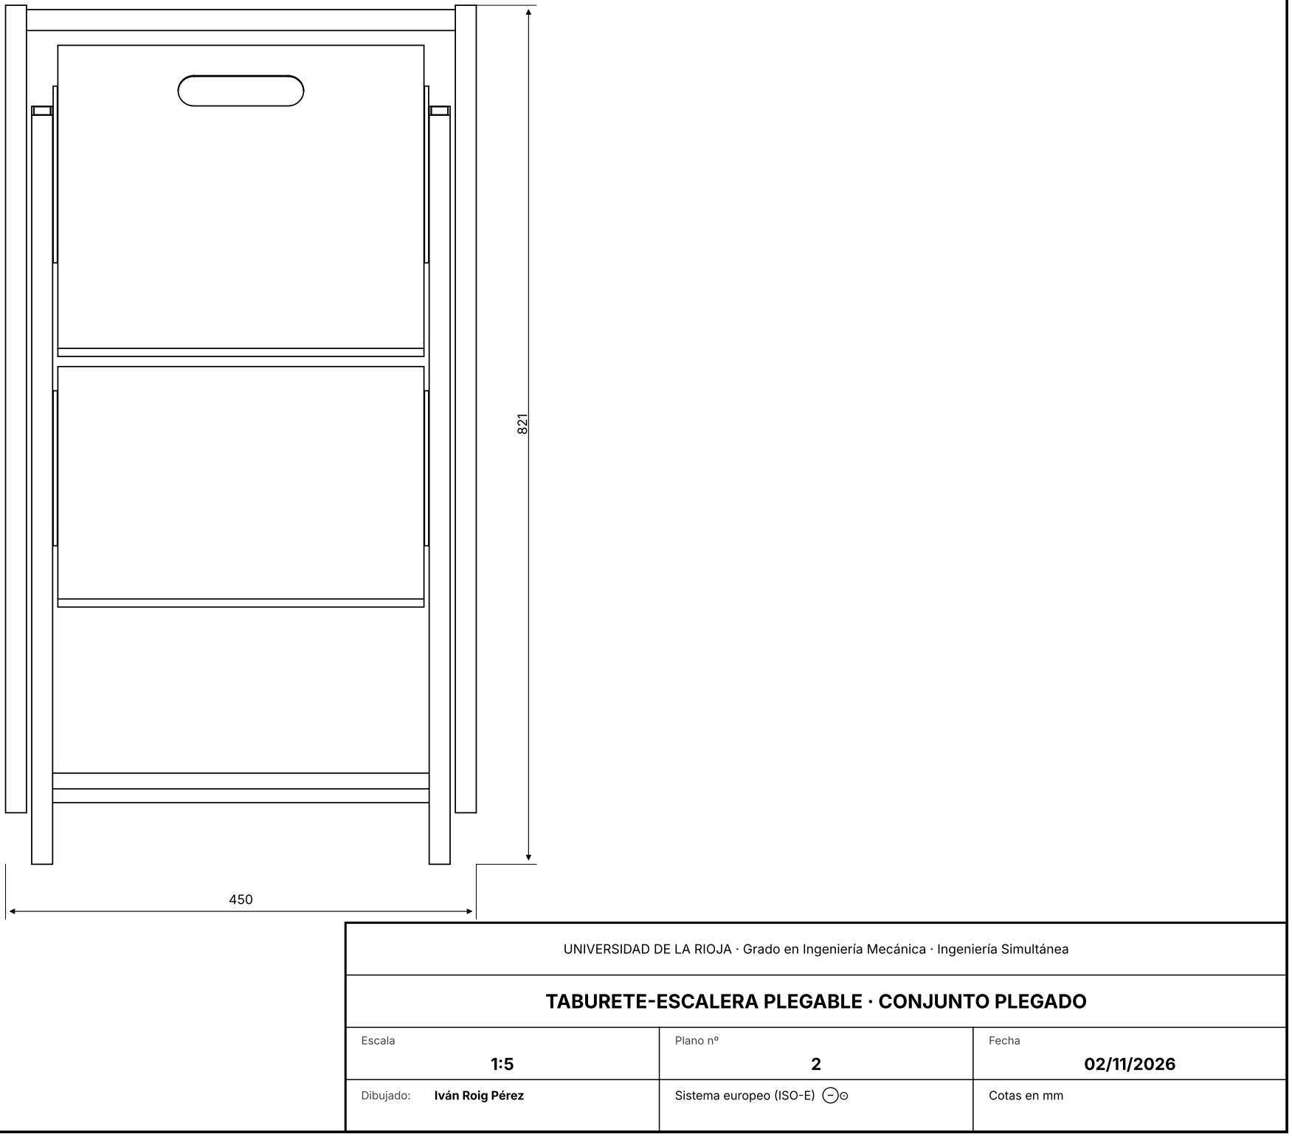
[picture p75: figure]
Escala; Plano nº; Fecha

UNIVERSIDAD DE LA RIOJA · Grado en Ingeniería Mecánica · Ingeniería Simultánea

## TABURETE-ESCALERA PLEGABLE · CONJUNTO PLEGADO

ALZADO (vista lateral) | PERFIL (vista frontal)

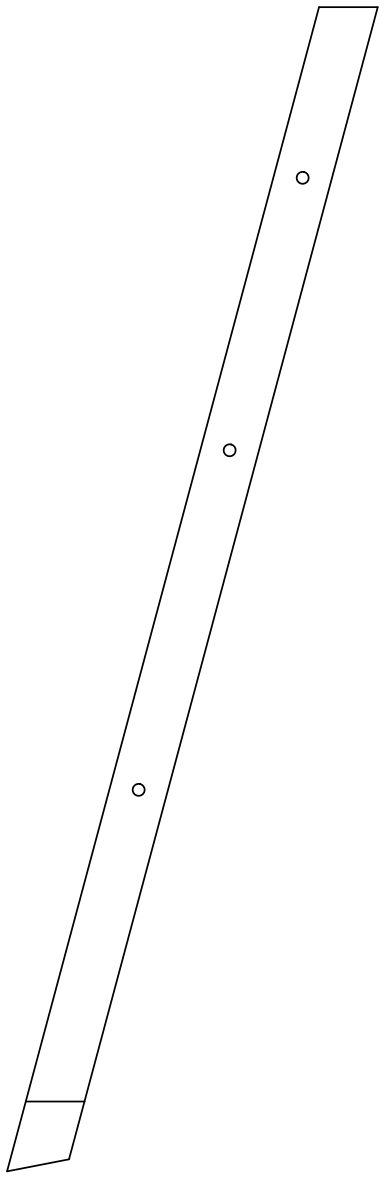
[picture p76: figure]

Espesor plegado medido perpendicular a los largueros: 40 mm. Volumen plegado: 861 × 450 × 40 mm.

C

A

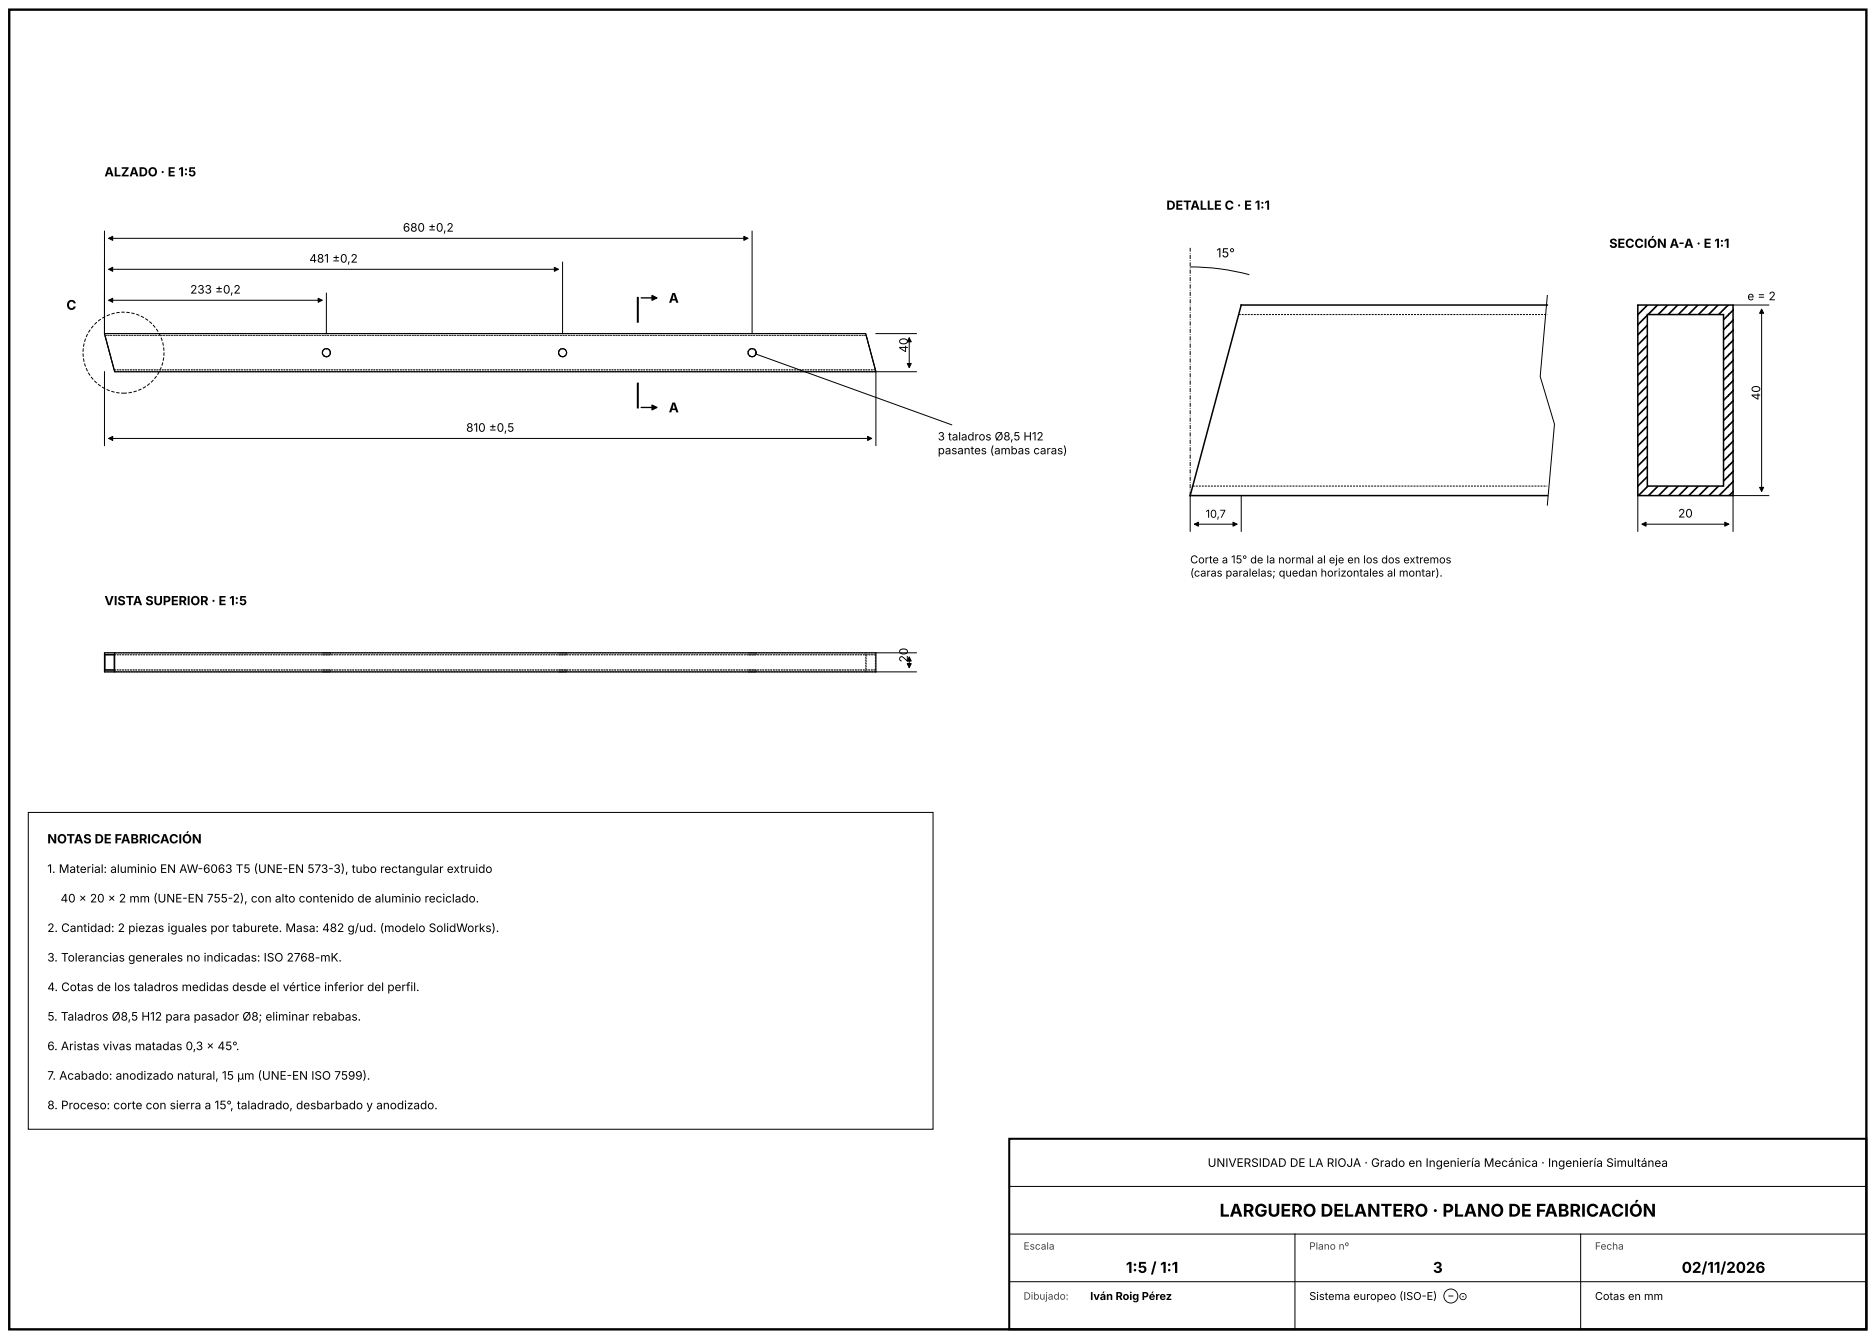
[picture p77: page 3]
Escala; Plano nº; Fecha; ALZADO · E 1:5; VISTA SUPERIOR · E 1:5; DETALLE C · E 1:1; SECCIÓN A-A · E 1:1

3 taladros Ø8,5 H12
pasantes (ambas caras)

Corte a 15° de la normal al eje en los dos extremos
(caras paralelas; quedan horizontales al montar).

NOTAS DE FABRICACIÓN

1. Material: aluminio EN AW-6063 T5 (UNE-EN 573-3), tubo rectangular extruido

40 × 20 × 2 mm (UNE-EN 755-2), con alto contenido de aluminio reciclado.

2. Cantidad: 2 piezas iguales por taburete. Masa: 482 g/ud. (modelo SolidWorks).

3. Tolerancias generales no indicadas: ISO 2768-mK.

4. Cotas de los taladros medidas desde el vértice inferior del perfil.

5. Taladros Ø8,5 H12 para pasador Ø8; eliminar rebabas.

6. Aristas vivas matadas 0,3 × 45°.

7. Acabado: anodizado natural, 15 µm (UNE-EN ISO 7599).

8. Proceso: corte con sierra a 15°, taladrado, desbarbado y anodizado.

UNIVERSIDAD DE LA RIOJA · Grado en Ingeniería Mecánica · Ingeniería Simultánea

LARGUERO DELANTERO · PLANO DE FABRICACIÓN
