ivanroigperez/prueba/(commit log)

2026-09-29 Mejorar ilustraciones del apartado 1.1 y añadir gráfica de accidentes DADO
    Claude-Session: https://claude.ai/code/session_01GULK22xqK1fWX4r8uc4cx1
2026-09-29 Revisar etapa inicial y redactar etapas de información y técnico-creativa; añadir guía de modelado CAD
    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
2026-09-29 Verificar datos pendientes: reivindicaciones y dibujos de patentes, antropometría INSHT, celda TRIZ 33/27 y legislación; corregir tablas y numeración de ilustraciones
    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
2026-09-29 Añadir modelo CAD verificado (cinemática, masas, STEP) y macro de SolidWorks para generar las piezas
    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
    [biela_plataforma.step, conjunto_abierto.step, conjunto_abierto.stl, conjunto_plegado.step, conjunto_plegado.stl, larguero_delantero.step, pasador.step, pata_trasera.step]
2026-09-29 Añadir macro de corrección de materiales (nombres en español)
    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
2026-09-29 Añadir macro de ensamblaje (abierto/plegado) y masas medidas en SolidWorks
    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
    [biela_plataforma.step, biela_plataforma.stl, larguero_delantero.step, larguero_delantero.stl, masas_solidworks.csv, pasador.step, pasador.stl, pata_trasera.step]
2026-09-29 Corregir orientación de las patas traseras en la macro de ensamblaje
    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
2026-09-29 Añadir apartado 3.4 (rediseño cinemático y modelo SolidWorks) y etapa 4 de evaluación (ACV y matriz de decisión)
    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
2026-09-29 Añade etapa de rediseño (QFD, AMFEC, análisis del valor), anexos con planos, portada e índice
    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
    [biela_plataforma.step, larguero_delantero.step, pasador.step, pata_trasera.step, peldano.step, plataforma.step, taco.step, tirante_peldano.step]
2026-09-29 Añade macro de SolidWorks para generar los planos
    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
2026-09-29 Portada nueva, nombre del autor, índice con páginas, revisión de coherencia y documento de dudas
    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
    [biela_plataforma.step, biela_plataforma.stl, larguero_delantero.step, larguero_delantero.stl, pasador.step, pasador.stl, pata_trasera.step, pata_trasera.stl]
2026-09-29 Revisión: decisión por requisitos imprescindibles, comprobaciones de cálculo, listas de ilustraciones y tablas
    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
2026-11-02 Adapta el trabajo al mensaje del profesor: estructura, ACV con Eco-it y etapa de realización
    - Etapa inicial: nuevo apartado 1.7 con el árbol de estructura del producto.
    - Etapa de evaluación: capítulo 4 en formato Eco-it, con los datos de entrada
    preparados y los resultados pendientes resaltados.
    - Etapa de realización: plano de conjunto y plano de fabricación del larguero.
    - Guía para la práctica de Eco-it y documento de dudas actualizado.
    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
2026-11-02 Ignora la caché de Python (__pycache__)
    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
2026-11-02 Reescribe el texto con el estilo de Iván en Trabajo_Taburete_v2.docx
    - Frases más cortas, registro impersonal y conectores sin repetir.
    - Comillas “ ”, sin ≈, rayas ni · como separador; pies y títulos unificados.
    - Se mantienen los huecos de Eco-it en amarillo. El original no cambia.
    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
2026-11-03 Añade los resultados de Eco-it de la alternativa 2 con sus capturas
    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
2026-11-03 Añade los resultados de Eco-it de la variante con aluminio reciclado
    Tabla 14 completa (8,6 / 0 / 1,9 / 10,5 kg CO2-eq), párrafo y gráfico
    de la variante en el apartado 4.3 y valor de la conclusión (70 % menos).
    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
2026-11-03 Limita el ACV de Eco-it a la alternativa 2 y reordena el capítulo 4
    El profesor pide un pequeño ACV del producto, e Iván decide hacerlo
    solo de la alternativa elegida. El capítulo 4 queda en 4.1 selección
    frente al EDP, 4.2 metodología y datos del ACV, 4.3 resultados y
    4.4 conclusiones. Se quitan las partes de las alternativas 1 y 3, la
    comparativa y la nota; ya no queda texto en amarillo. Se renumeran
    tablas e ilustraciones y se actualiza el documento de dudas.
    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
2026-11-03 Corrige la celda TRIZ 13/7, el precio del IKEA BOLMEN y aclara las masas del ACV
    - 3.2: la celda 13/7 de la matriz clásica es 28, 10, 19 y 39 (decía 1 en
    lugar de 19); comprobadas también 14/1 y 33/27.
    - 2.2: el BOLMEN cuesta 4,99 € en ikea.es (decía 1,50 €); Tabla 4 e
    Ilustración 6 actualizadas.
    - 4.2: el ACV usa las masas del modelo (3,17 kg) sin los refuerzos del
    apartado 3.5, que llevan la masa a unos 3,46 kg.
    - Celdas de tabla que salían a 11 pt, al tamaño del resto de su tabla.
    - Documento de dudas actualizado con el resultado de las comprobaciones.
    Claude-Session: https://claude.ai/code/session_01GULK22xqK1fWX4r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
2026-11-03 Precisa en el documento de dudas el uso del parámetro 13 de TRIZ
    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
2026-11-03 Prepara la carpeta de entrega
    Trabajo en Word y PDF (43 páginas) y anexo de planos en A3. Se ponen
    título y autor en las propiedades de los archivos y se quita el aviso
    de actualizar campos al abrir el Word.
    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
2026-11-03 Añade la carpeta comprimida con la entrega, las macros de SolidWorks y el hueco para Eco-it
    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
2026-11-03 Quita la carpeta comprimida con las macros de la entrega
    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
2026-11-03 Pone en mayúsculas el título de la bibliografía, como el resto de títulos
    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
2026-11-07 Añade la versión reducida del trabajo (26 páginas)
    Deja solo lo que pide el profesor: etapa inicial, información (costes,
    mercado, EDP, patentes y legislación), mapa mental y TRIZ, ACV con Eco-it
    y planos. Quita el capítulo de rediseño y los apartados 2.4 y 2.7 a 2.11,
    la tabla de los 39 parámetros de TRIZ, el texto de las reivindicaciones y
    las figuras y tablas que repetían datos. El trabajo completo no cambia.
    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
